ChristianAffinity/Cruz-AVEIRO/Pantilla Calidad Cruces.docx

# CONTROL DE CALIDAD CRUCES

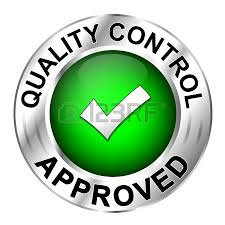
[picture p1: figure]

F-G-0602

DATOS DEL EQUIPO
Modelo: | Fecha fabricación:
Denominación: | Nº Serie:

VERIFICACIÓN COMPLEMENTOS [ ]
A N/A - Carcasa [ ] [ ] - Soporte [ ] [ ] | A N/A - Router [ ] [ ]

VERIFICACIÓN MECANICA [ ]
A N/A - Soporte Pared. [ ] [ ] - Color Carcasa. [ ] [ ] | A N/A - Caja Electrónica. [ ] [ ]

VERIFICACIÓN FUNCIONAL [ ]
A N/A - Animaciones. [ ] [ ] - Hora. [ ] [ ] - Control de Brillo. [ ] [ ] - Configuración Router [ ] [ ] | A N/A - Comunicación WI-FI [ ] [ ] - Leds. [ ] [ ] - Sonda de temperatura [ ] [ ] - Test 3 días [ ] [ ]

VERIFICACIÓN OPTICA [ ]
A N/A - Rayas y raspaduras [ ] [ ] - Color homogéneo Leds [ ] [ ] - Hora correcta [ ] [ ] - Leds RGB todos encendidos [ ] [ ] | A N/A - Etiqueta N.º de serie equipo [ ] [ ] - Etiqueta N.º de serie piezas [ ] [ ] - Color blanco de leds Homogéneo [ ] [ ]

Este equipo ha superado las pruebas y controles de calidad para su suministro

Fdo.: Responsable Calidad

| CONTROL VERIFICACIÓN MONTAJE DE CRUCES
| CODIGO:
| FECHA:
| NUMERO SERIE:

TECNOLOGIAS ADE S.L. C/ Navarra, 38 C/ Solsona, 152 Tlf.: +34 902 103 686 28961 Villanueva de la Cañada 08223 Terrassa e-mail: affinity@affinityelectronics.com Madrid Barcelona http://www.affypharmacy.com/ ESPAÑA
