ChristianAffinity/Cruz-AVEIRO/P10/P10SMD 320x320mm-module and accessories dimension.pptx

Cabinet :
1. Make 5 windows on corresponding position of Cross in front
2. The back can be a complete sheet, welding some Threaded poles to mount power supplies, Receiving Card, T3 Card
3. If it works in very hot temperature, a fan can be added for cooling
4. All parts can be assembled and dismounted from front
5. Reserve a hole for AC Mains power cable input
6. Reserve 2 holes for T3 Card Antennas
7. Keep all holes and fixing positions water resisted.

P10 Module: 320x320x22mm

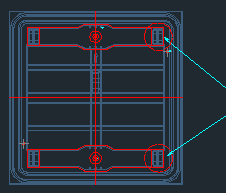
[picture p2: figure]

Cabinet Reference

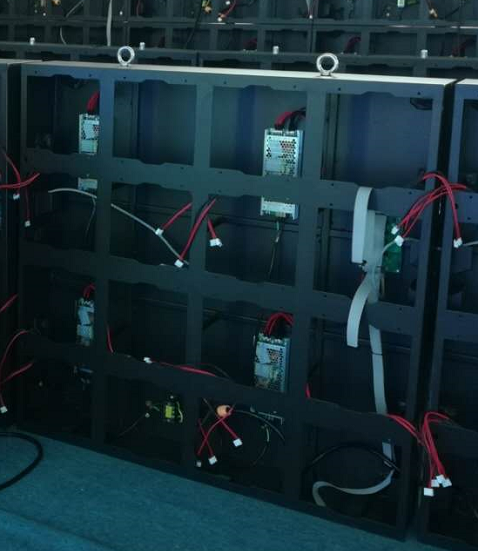
[picture p3: figure]

Locks

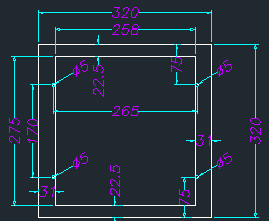
[picture p4: figure]

## Slide 2

Power Supply: VAT-UP300S-5-60L-A

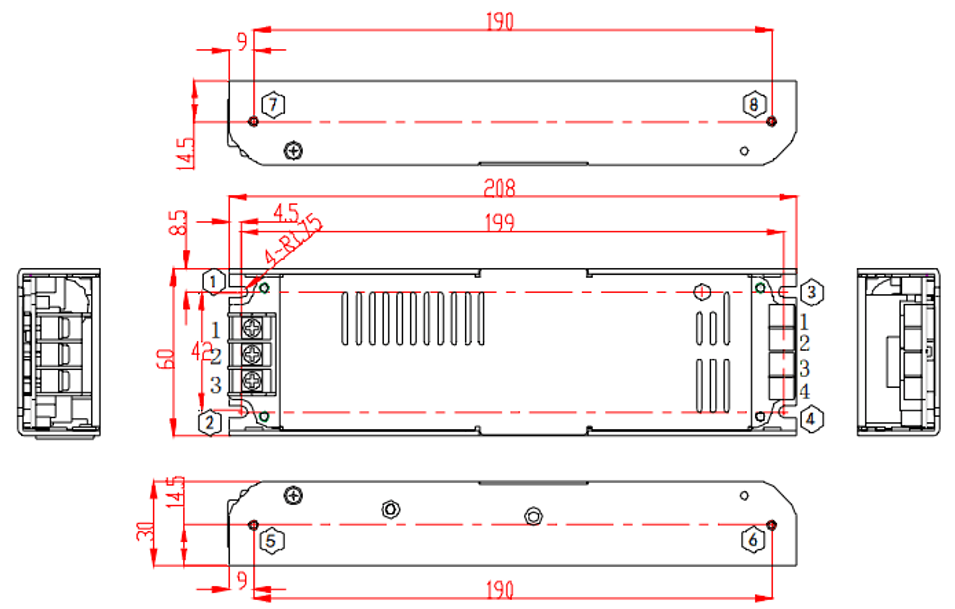
[picture p5: figure]

## Slide 3

WiFi Sending Card: T3

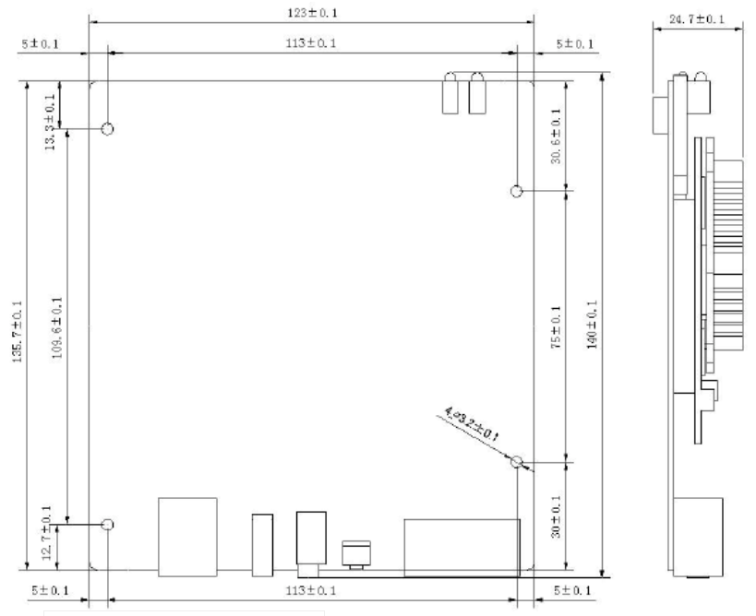
[picture p6: figure]

Receiving Card: MRV336

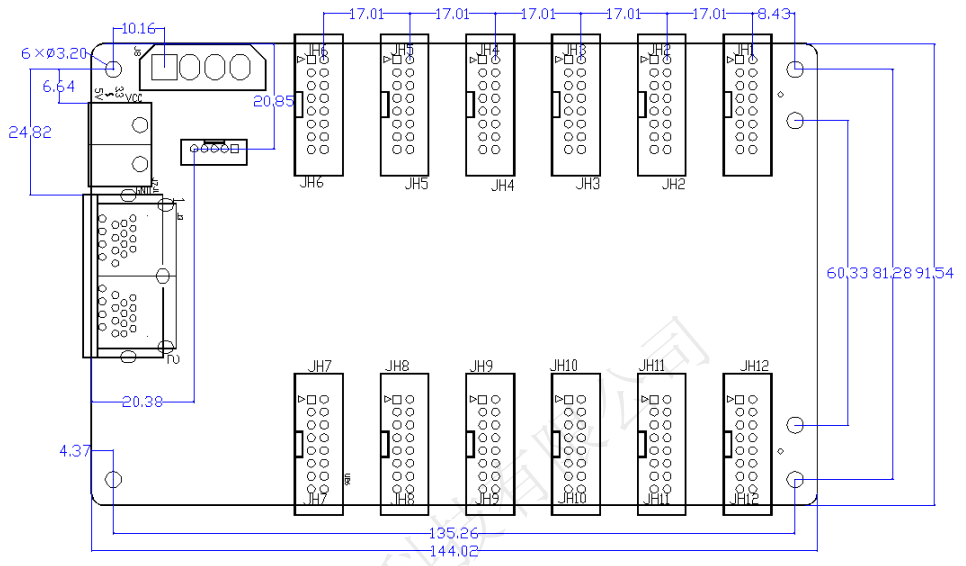
[picture p7: figure]
