ChristianAffinity/Cruz-AVEIRO/nova/media/7c5a1322309a635d3d2489f45fb7a09a.gif

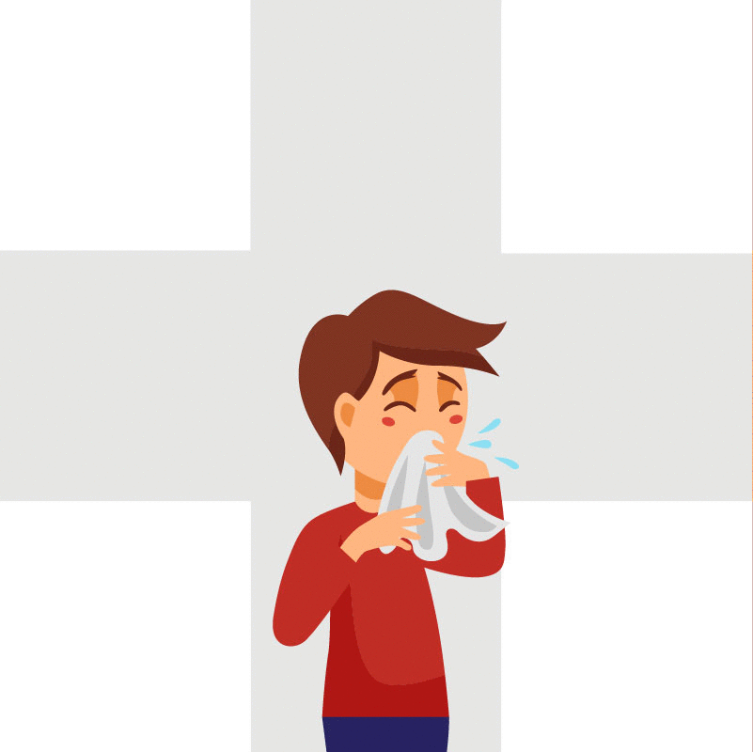
nova/media/7c5a1322309a635d3d2489f45fb7a09a.gif
