ChristianAffinity/Cruz-AVEIRO/nova/media/1917d6bfe66c499b5e2b0775bed98a57.gif

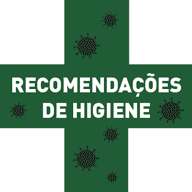
nova/media/1917d6bfe66c499b5e2b0775bed98a57.gif
