ChristianAffinity/Cruz-AVEIRO/nova/media/681648bbcf8f7aeb54e717b080c021fe.gif

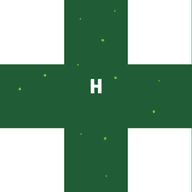
nova/media/681648bbcf8f7aeb54e717b080c021fe.gif
