ChristianAffinity/Cruz-AVEIRO/nova/media/ae6a9462dccd09d8ac21188c02434fcc.gif

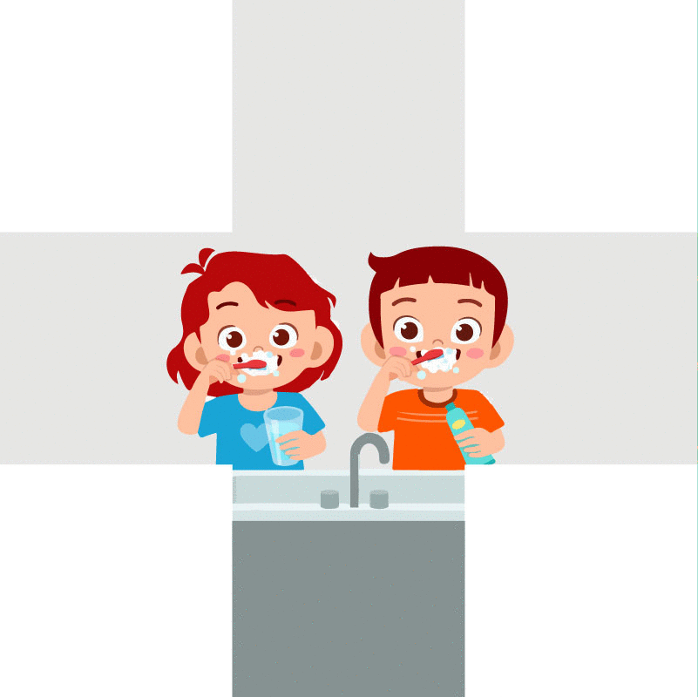
nova/media/ae6a9462dccd09d8ac21188c02434fcc.gif
