ChristianAffinity/Cruz-AVEIRO/nova/media/c2ec6c5f07720dbcca98fb366b5a2c16.gif

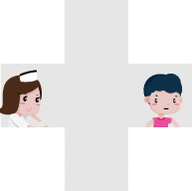
nova/media/c2ec6c5f07720dbcca98fb366b5a2c16.gif
