ChristianAffinity/Cruz-AVEIRO/nova/program/AveiroP667_288X144/e09379c5-8bc2-414f-90a1-663403e3ac25.png

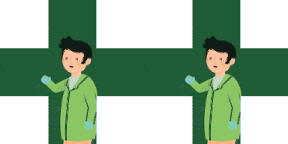
nova/program/AveiroP667_288X144/e09379c5-8bc2-414f-90a1-663403e3ac25.png
