ChristianAffinity/Cruz-AVEIRO/PlACA_2_ RECEIVING CARD p667 v2.png

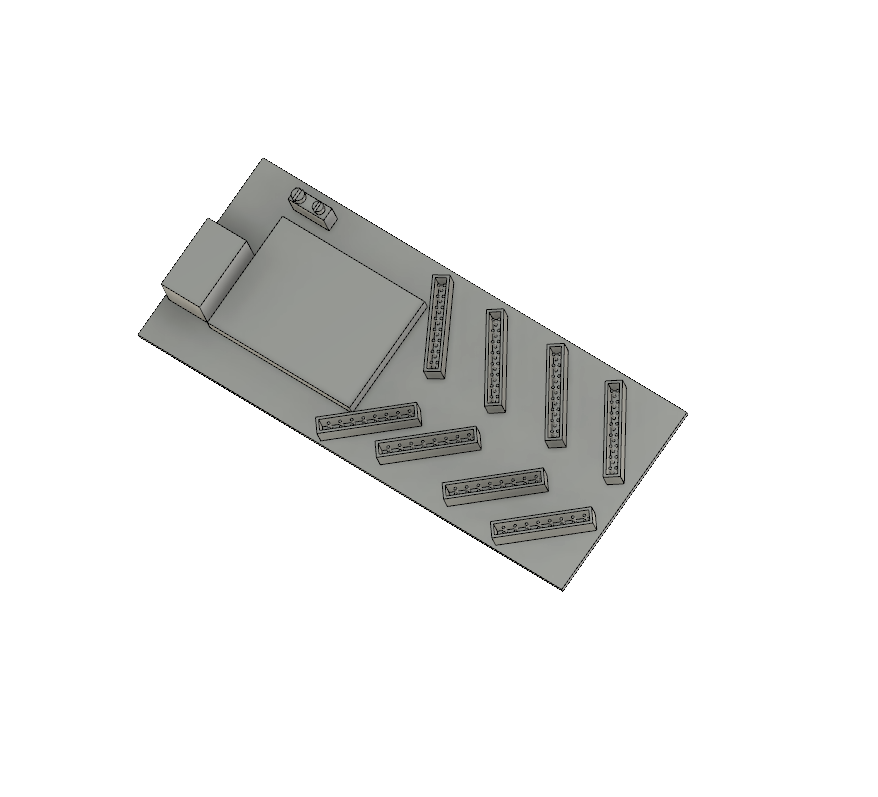
PlACA_2_ RECEIVING CARD p667 v2.png
