ChristianAffinity/Cruz-AVEIRO/Escandallo Aveiro P6.67 y P10.xlsx

Sheet: aveiro p6,67
 |  |  |  | USD | 0.83
 |  |  |  | Portes | 15%
 |  | COSTE CRUZAVEIRO P6,67 |  |  |  | 1621.47 | 5% |  | 25% | 30% | 35% | 40% | 44%
articulo | componente | R04V0001 | unidades |  | cost_ult1 |  |  | 1702.546461 | 2270.061948 | 2432.20923 | 2619.302248 | 2837.577435 | 3123.938461
R04V0001 | LMP10 | MODULOS LED P6,67 | 10 | 71 | 69.58 | 695.8000
R04V0001 | WC | WIFI CARD TB2-4G | 1 | 220 | 215.60 | 215.6000
R04V0001 | RC | RECEIVING CARD MODELO A5S PLUS | 1 | 25 | 24.50 | 24.5000
 |  | CABLE PLANO 20 VÍAS(ADESKT16H2 - 2,54) 20CM | 4
 |  | CABLE PLANO 20 VÍAS(ADESKT16H2 - 2,54) 80CM | 6
 |  | CABLE ALIMENTACIÓN ROJO / NEGRO 3MTR (MODULOS) | 10
 |  | CABLE RJ45 UTP 3MTR | 1
 |  | TORNILLO M3X15 DIN965 | 4
 |  | TUERCAS M3 | 4
 |  | SEPARADORES PVC 5MM/8MM | 4
 |  | Ensamblaje | 1 |  | 20.00 | 20.0000
 |  | CABLE ALIMENTACIÓN (R y N) RECEIVING CARD 3 MTR PUNTERAS A CONECTOR HEMBRA 4 VIAS TIPO JST PASO 3,96 ( VER PLANO) S=1,5MM | 1
 |  | TUBO CORRUGADO EUROFLEX-21 11/F 15 D 6x4 25MM | 1
 |  |  |  |  |  | 955.9000
articulo | componente | SOPORTE CRUZ AVEIRO | unidades |  | cost_ult1
 | D15V-3 | SOPORTE DE PARED 30CM | 1 |  | 32.00 | 32.0000
SE0401030000P | D04V-32 | SOPORTE CRUZ LEON - TURIN | 1 |  | 90.00 | 90.0000
SE0401030000P | TORM6X16DIN933I | TORNILLO M 6X16 DIN 933 HEXAGONAL AC. INOX. | 2 |  | 0.05 | 0.1004
SE0401030000P | TORM6X40DIN933I | TORNILLO M 6X40 DIN 933 HEXAGONAL AC. INOX. | 1 |  | 0.09 | 0.0876
SE0401030000P | ARANM4DIN9021ZN | ARANDELA M 8 DIN 9021 INOX | 3 |  | 0.01 | 0.0193
 |  |  |  |  |  | 122.2073
articulo | componente | ENVOLVENTES | unidades |  | cost_ult1
DE04VI85 | ECRGB P6 | ENVOLVENTE CRUZ RGB P10 | 1 |  | 290.00 | 290.0000
DE04VI85 | TORM4X15DIN933I | TORNILLO M4X15 DIN 933 EXAGONAL AC. INOX. | 4 |  | 0.03 | 0.128
DE04VI85 | ARANDELAP18 | ARANDELA A2 C/GOMA P18 | 4 |  | 0.07 | 0.2902
 |  |  |  |  |  | 290.4180
articulo | componente | FUENTE DE ALIMENTACIÓN | unidades |  | cost_ult1
FA2-1F | FACRGB | FUENTE ALIMENTACIÓN CRUZ RGAB P10 | 2 | 70 | 68.60 | 137.2000
FA2-1F | CV | CABLES VARIOS | 1 |  | 30.00 | 30.0000
FA2-1F | ENSAMBLAJE FA1 | ENSAMBLAJE FUENTE ALIENTACION 1 FUENTE | 1 |  | 15.00 | 15.0000
FA2-1F | AFY2500F-B-2P | BORNA 2V HEMBRA ACODADA 5.08 | 1 |  | 0.07 | 0.0695
FA2-1F | BRIDA290MM | BRIDA 290 mm X4.8 | 3 |  | 0.04 | 0.1155
FA2-1F | DIN934 M3 | TUERCA M3 DIN 934 ZN | 18 |  | 0.03 | 0.5512
FA2-1F | SEPARADOR8MMPVC | SEPARADOR 8 MM NYLON M3 | 4 |  | 0.02 | 0.0976
FA2-1F | ARANM4DIN9021ZN | ARANDELA M 8 DIN 9021 INOX | 2 |  | 0.01 | 0.0129
FA2-1F | CLEMA250 | CLEMA PARA CABLE 2.5MM (DE 10MM) | 1 |  | 0.86 | 0.8600
FA2-1F | TUBOFLEX21 | TUBO CORRUGADO EUROFLEX-21 11/F 15 D 6x4 25MM | 1 |  | 1.44 | 1.4400
 |  | CBCRUZFFRA | 1
 |  | CBCRUZFFRM | 1
FA2-1F | F10T | CONJUNTO CHAPA FUENTE 1F.A. NUEVA 9006 | 1 |  | 56.05 | 56.0472
 |  |  |  |  |  | 241.3938
 |  | ETIQUETAS
FA2-1F | ETIQUETA-GENERAL | ETIQUETA Nº SERIE AFFINITY | 4 |  | 0.07 | 0.266
R04V0001 | ETIMERCAN | ETIQUETA MERCANCIA ASEGURADA | 1 |  | 0.33 | 0.334
R04V0001 | ETIATENCION | ETIQUETA ATENCION | 1 |  | 1.00 | 1.000
R04V0001 | ETIQUETA-CRUCES | ETIQUETA Nº SERIE PARA CRUCES | 1 |  | 0.20 | 0.20
 |  |  |  |  |  | 1.800
 |  | EMBALAJE
R04V0001 | EMBPROTCRUZ | CARTON PROTECCION CRUCES | 2 |  | 0.89 | 1.780
SE0401030000P | EMBSOPCRUZ | CAJA SOPORTE CRUZ 230 X 230 X 650 | 1 |  | 0.89 | 0.885
R04V0001 | EMBC0950 | CAJA CRUCES 950 x 160 x 1350 | 1 |  | 4.57 | 4.570
 |  | PERFILES AZULES | 1 |  | 1.64 | 1.64
 |  | BURBUJA PEQ | 1 |  | 0.85 | 0.85
 |  | PAKING LIST | 1 |  | 0.03 | 0.03
 |  |  |  |  |  | 9.75

Sheet: aveiro p10
 |  |  | usd | 0.84
 |  |  | Portes | 10%
 |  | COSTE CRUZ AVEIRO P10 |  |  |  | 1480.2231 | 5% |  | 25% | 30% | 35% | 40% | 44%
articulo | componente | R04V0001 | unidades |  | cost_ult1 |  |  | 1554.234286 | 2072.312382 | 2220.334695 | 2391.129672 | 2590.390477 | 2851.80603
R04V0001 | LMP10 | MODULOS LED P10 | 10 | 56 | 52.64 | 526.4000
R04V0001 | WC | WIFI CARD TB2-4G | 1 | 220 | 206.80 | 206.8000
R04V0001 | RC | RECEIVING CARD MODELO MRV 336 | 1 | 25 | 23.50 | 23.5000
 |  | CABLE PLANO 16 VÍAS(ADESKT16H2 - 2,54) 20CM | 8
 |  | CABLE PLANO 16 VÍAS(ADESKT16H2 - 2,54) 80CM | 12
 |  | CABLE ALIMENTACIÓN ROJO / NEGRO 3MTR (MODULOS) | 10
 |  | CABLE RJ45 UTP 3MTR | 1
 |  | CABLE ALIMENTACIÓN (R y N) RECEIVING CARD 3 MTR PUNTERA A HORQUILLA | 1
 |  | TORNILLO M3X15 DIN965 | 4
 |  | TUERCAS M3 | 4
 | SEPARADOR8MMPVC | SEPARADORES PVC 5MM/8MM | 4
 |  | ENSAMBLAJE | 1 |  | 25.00 | 25.0000
 |  | TUBO CORRUGADO EUROFLEX-21 11/F 15 D 6x4 25MM | 1 |  | 1.44 | 1.4400
 |  |  |  |  |  | 783.1400
articulo | componente | SOPORTE CRUZ AVEIRO | unidades |  | cost_ult1
 | D15V-3 | SOPORTE DE PARED 30CM | 2 |  | 32.00 | 64.0000
SE0401030000P | D04V-32 | SOPORTE CRUZ AVEIRO | 1 |  | 90.00 | 90.0000
 |  | TAPON NEGRO | 2
SE0401030000P | TORM6X16DIN933I | TORNILLO M 6X16 DIN 933 HEXAGONAL AC. INOX. | 4 |  | 0.05 | 0.2009
SE0401030000P | TORM6X40DIN933I | TORNILLO M 6X40 DIN 933 HEXAGONAL AC. INOX. | 4 |  | 0.09 | 0.3502
SE0401030000P | ARANM4DIN9021ZN | ARANDELA M 8 DIN 9021 INOX | 6 |  | 0.01 | 0.0386
 |  |  |  |  |  | 154.5898
articulo | componente | ENVOLVENTES | unidades |  | cost_ult1
DE04VI85 | ECRGB P6 | ENVOLVENTE CRUZ RGB P10 | 1 |  | 290.00 | 290.0000
 |  |  |  |  |  | 290.0000
articulo | componente | FUENTE DE ALIMENTACIÓN | unidades |  | cost_ult1
FA2-1F | RSP-500-5 | FUENTE ALIMENTACIÓN CRUZ RGAB P10 | 2 | 72 | 67.68 | 135.3600
FA2-1F |  | PLACA CPU WIFI | 1 |  | 30.00 | 30.0000
 |  | ROUTER WIFI | 1
 |  | TORNILLO C/PLANA M4*10 | 8
 | CAB000330 | CABLE RED | 1
FA2-1F | ENSAMBLAJE FA1 | ENSAMBLAJE FUENTE ALIENTACION 1 FUENTE | 1 |  | 15.00 | 15.0000
FA2-1F | BRIDA290MM | BRIDA 290 mm X4.8 | 3 |  | 0.04 | 0.1155
FA2-1F | CLEMA250 | CLEMA PARA CABLE 2.5MM (DE 10MM) | 2 |  | 0.86 | 1.7200
 |  | CBCRUZFFRA | 1
 |  | CBCRUZFFRM | 1
FA2-1F | F40T | CONJUNTO CHAPA FUENTE 1F.A. NUEVA 9006 | 1 |  | 56.05 | 56.0472
 |  |  |  |  |  | 238.2427
 |  | ETIQUETAS
FA2-1F | ETIQUETA-GENERAL | ETIQUETA Nº SERIE AFFINITY | 2 |  | 0.07 | 0.133
R04V0001 | ETIMERCAN | ETIQUETA MERCANCIA ASEGURADA | 1 |  | 0.33 | 0.334
R04V0001 | ETIATENCION | ETIQUETA ATENCION | 1 |  | 1.00 | 1.000
R04V0001 | ETIQUETA-CRUCES | ETIQUETA Nº SERIE PARA CRUCES | 1 |  | 0.20 | 0.20
 |  |  |  |  |  | 1.667
 |  | EMBALAJE
R04V0001 | EMBPROTCRUZ | CARTON PROTECCION CRUCES | 2 |  | 0.89 | 1.780
SE0401030000P | EMBSOPCRUZ | CAJA SOPORTE CRUZ 230 X 230 X 650 | 1 |  | 0.89 | 0.885
R04V0001 | EMBC1250 | CAJA CRUCES 1250 x 160 x 1500 | 1 |  | 7.40 | 7.400
 |  | PERFILES AZULES | 1 |  | 1.64 | 1.64
 |  | BURBUJA PEQ | 1 |  | 0.85 | 0.85
 |  | PAKING LIST | 1 |  | 0.03 | 0.03
 |  |  |  |  |  | 12.58
 |  |  |  |  |  | 1480.22
