ChristianAffinity/Cruz-AVEIRO/CAD/CAD Fuente alimentación/Ensamblaje1.SLDASM

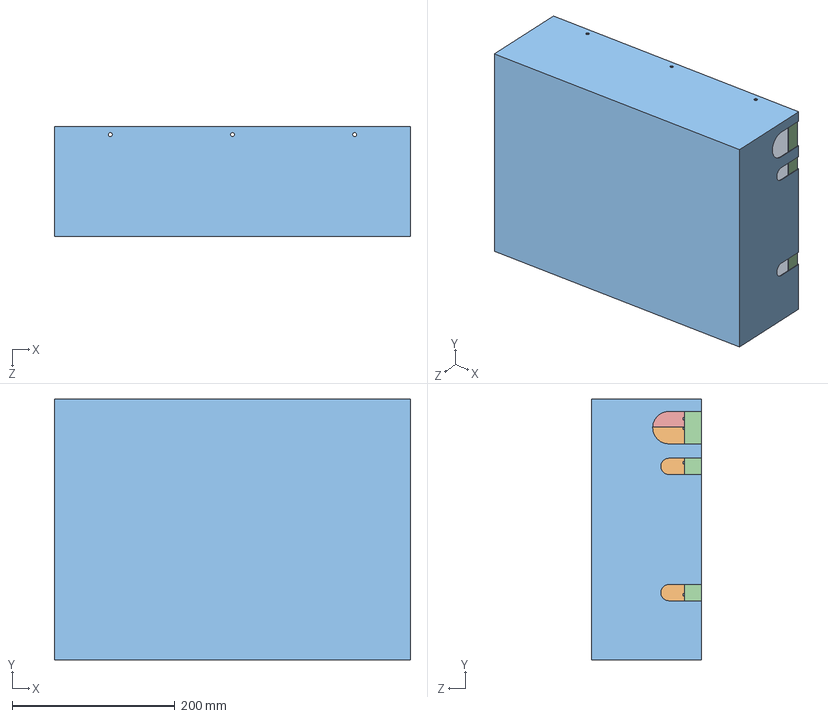
[picture p15: CAD file, 2021-09-20]
CAD/CAD Fuente alimentación/Ensamblaje1.SLDASM
437.0 x 320.0 x 135.0 mm
CHAPA
fuente RSP-500-5 x 2
tapa fuente aveiro
Base tapa fuente aveiro
proteccion fuente aveiro
