ChristianAffinity/Cruz-AVEIRO/CAD/CAD Fuente alimentación/3D/proteccion fuente aveiro.SLDPRT

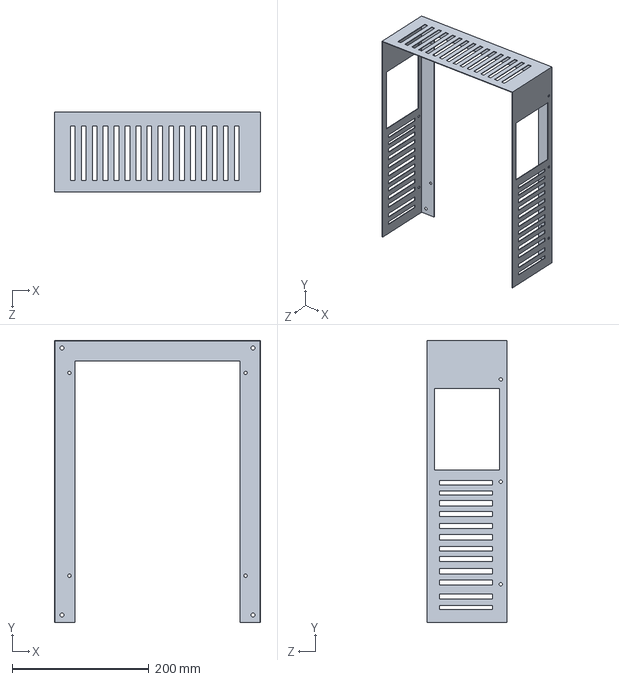
[picture p16: CAD file, 2021-09-20]
CAD/CAD Fuente alimentación/3D/proteccion fuente aveiro.SLDPRT
302.0 x 413.0 x 117.0 mm
