ChristianAffinity/Cruz-AVEIRO/CARA 1 Interior AVEIRO v20.step

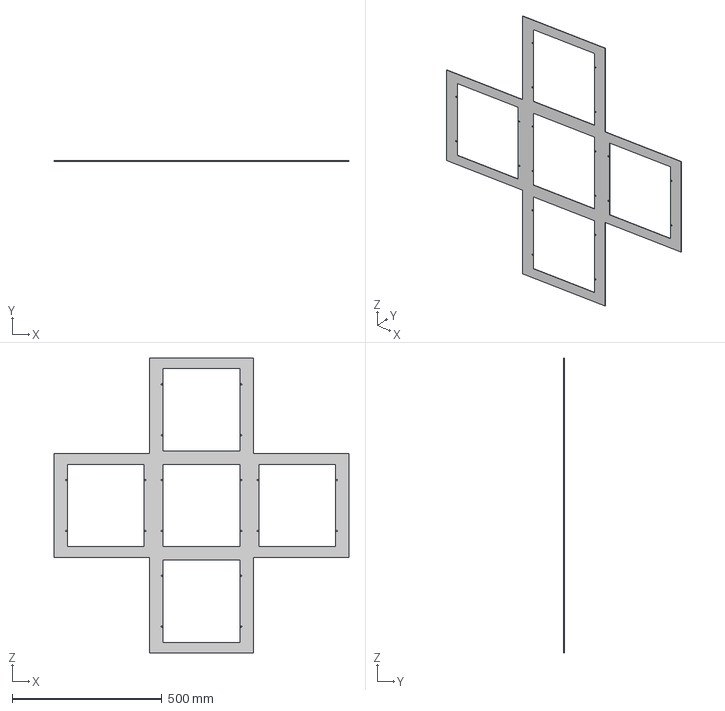
[picture p17: CAD file, 2022-04-19]
CARA 1 Interior AVEIRO v20.step
986.0 x 1.50 x 986.0 mm
