ChristianAffinity/Cruz-AVEIRO/CAD/CAD Fuente alimentación/3D/tapa fuente aveiro.SLDPRT

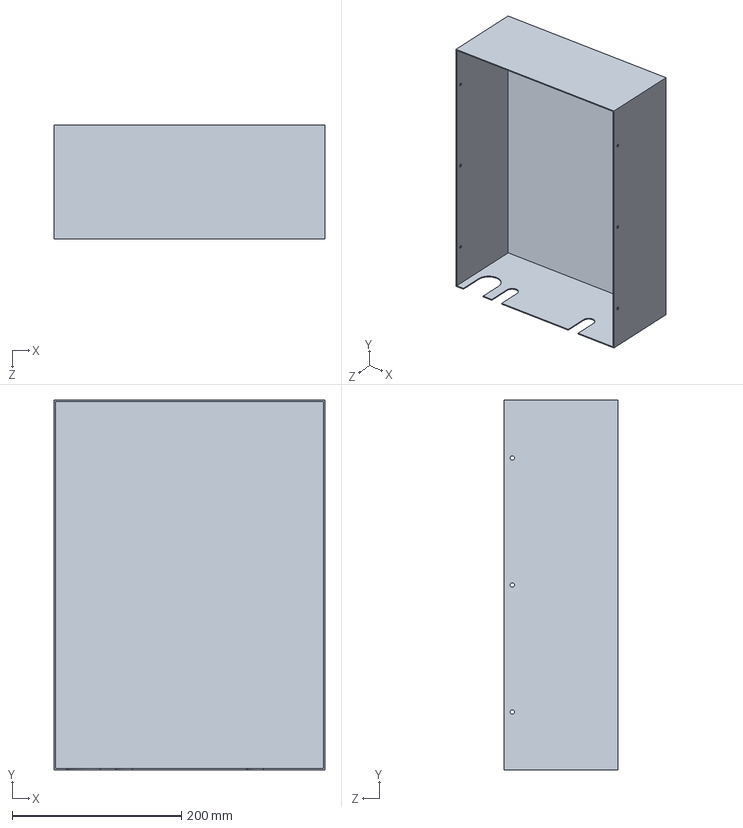
[picture p18: CAD file, 2021-09-20]
CAD/CAD Fuente alimentación/3D/tapa fuente aveiro.SLDPRT
320.0 x 437.0 x 135.0 mm
