ChristianAffinity/Cruz-AVEIRO/CAD/CAD Fuente alimentación/3D/Base tapa fuente aveiro.SLDPRT

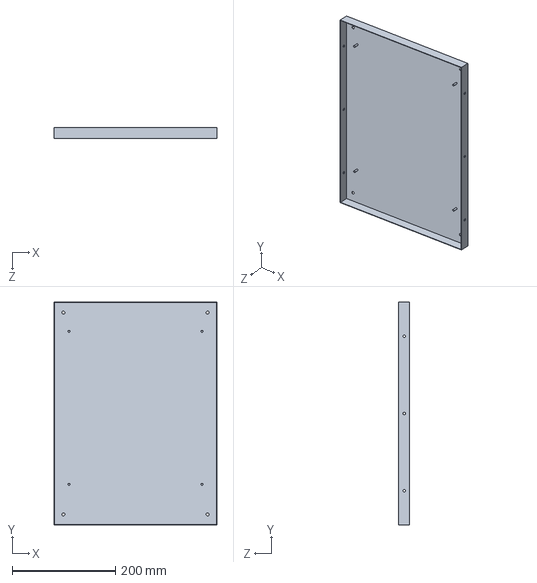
[picture p19: CAD file, 2021-09-20]
CAD/CAD Fuente alimentación/3D/Base tapa fuente aveiro.SLDPRT
316.0 x 433.0 x 21.0 mm
