ChristianAffinity/Cruz-AVEIRO/CAD/CAD Fuente alimentación/3D/fuente RSP-500-5.SLDPRT

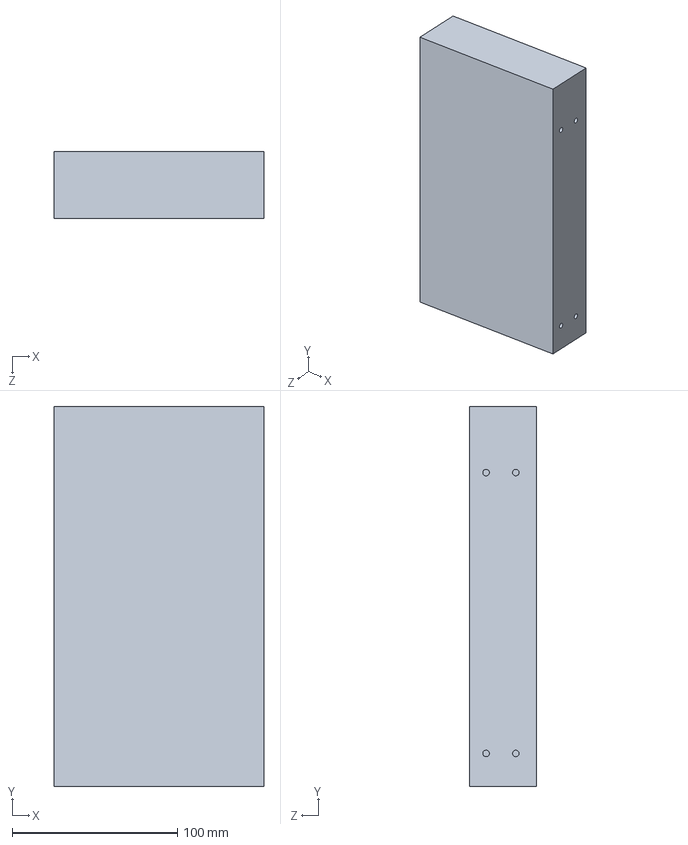
[picture p20: CAD file, 2021-09-20]
CAD/CAD Fuente alimentación/3D/fuente RSP-500-5.SLDPRT
127.0 x 230.0 x 40.5 mm
