ChristianAffinity/Cruz-AVEIRO/CAD/CAD Fuente alimentación/3D/CHAPA.SLDPRT

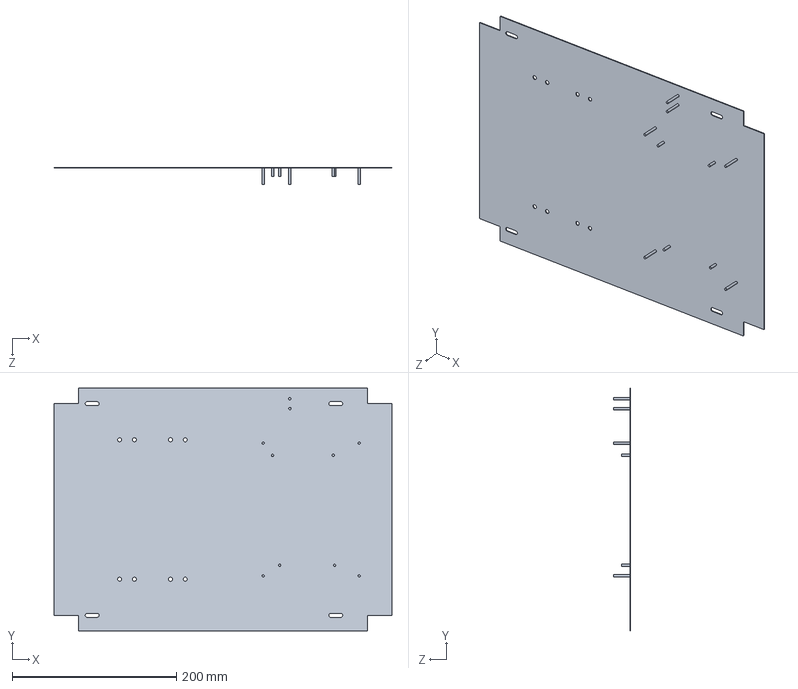
[picture p21: CAD file, 2021-09-20]
CAD/CAD Fuente alimentación/3D/CHAPA.SLDPRT
412.0 x 296.0 x 21.0 mm
