ChristianAffinity/Cruz-AVEIRO/(list of files, cad)

Other CAD files:
CAD/CAD Fuente alimentación/2D/Base tapa fuente aveiro.SLDDRW
CAD/CAD Fuente alimentación/2D/CHAPA.SLDDRW
CAD/CAD Fuente alimentación/2D/Plano cable 3m alimentacion paneles AVEIRO.SLDDRW
CAD/CAD Fuente alimentación/2D/proteccion fuente aveiro.SLDDRW
CAD/CAD Fuente alimentación/2D/tapa fuente aveiro.SLDDRW
