ChristianAffinity/Cruz-AVEIRO/P10/Double Side/P10 double-sided Cross Display Setup.docx

P10 Double-Sided Outdoor Cross Display Setup

General Information:

There are 4 sets of double-sided of P10 Cross LED displays in this order. Each set includes 10 modules of both faces, 1 TB2 WiFi card, 1 Receiving Card, 4 power supplies.

1. Module Layout

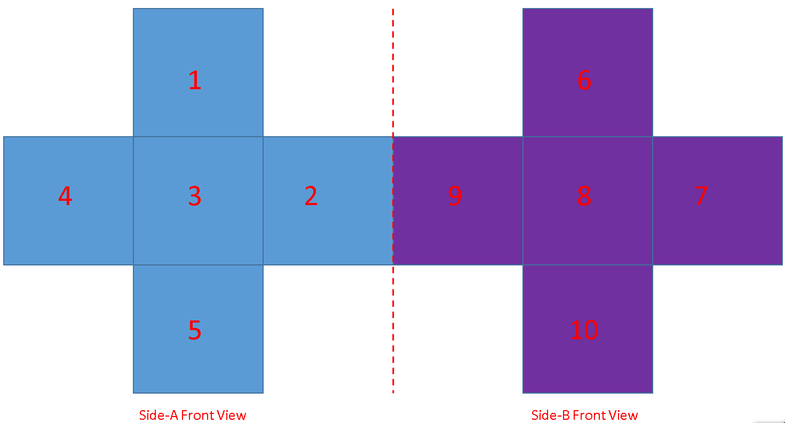
[picture p53: figure]

2. Cable Connection
1) DC 5V Power Cable

1 PSU can supply 3 Modules.

2) Flat Cables.

2 Kinds of Flat cables are included. The longer cable is from Receiving Card to Modules. The shorter one is from module to module.

According to above module layout of each side, run the flat cables from receiving card to modules, and from modules to modules accordingly. Please follow below table to connect the cables on corresponding connectors:

Longer Flat Cable Connections (Receiving Card - Module)
| Receiving Card | Module-Connector
Side A | JP1 | 1-IN1
| JP2 | 1-IN2
| JP3 | 2-IN1
| JP4 | 2-IN2
| JP5 | 5-IN1
| JP6 | 5-IN2
Side B | JP7 | 6-IN1
| JP8 | 6-IN2
| JP9 | 7-IN1
| JP10 | 7-IN2
| JP11 | 10-IN1
| JP12 | 10-IN2

Shorter Flat Cable Connections (Module - Module)
| Module-Connector | | Module-Connector
Side A | 2-OUT1 | 3-IN1 | 3-OUT1 | 4-IN1
| 2-OUT2 | 3-IN2 | 3-OUT2 | 4-IN2
Side B | 7-OUT1 | 8-IN1 | 8-OUT1 | 9-IN1
| 7-OUT2 | 8-IN2 | 8-OUT2 | 9-IN2

3) Net Cable

Connect Net Cable from WiFi Card “LED Out” to Receiving Card

3. Operation

The 2 sides of the display can be considered as a whole screen, 192x96 pixels. If the same content is expected to display on both sides, the screen can be divided into 2 windows when making programs.
