ChristianAffinity/Cruz-AVEIRO/Manual de Instalação da Cruz Aveiro_V1.2_PT (002).pdf

MANUAL DE INSTALAÇÃO CRUZ AVEIRO

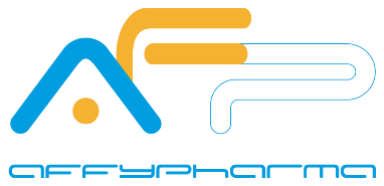
[picture p54: figure]
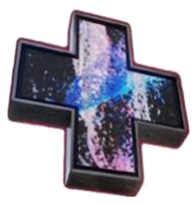
[picture p55: figure]

AFFINITY Group e-mail: affinity@affinityelectronics Tlf.: +34 918 155 723

# Manual de Instalação da Cruz Aveiro

HISTORICO DE APROVACION Y EDICIÓN

EDICIÓN Nº | FECHA | PUNTOS | CAUSE DE LOS CAMBIOS
01 | 16/12/21 | All | Creación del documento
02 | 29/03/2022 | 7 | Se añade la CPU T30

## 1. VERSÕES CRUZ AVEIRO

A cruz Aveiro é fabricada em duas versões:

Código | Descritivo | Pitch
CR4110211 | Cruz AVEIRO RGB P10 | P10
CR4010211 | Cruz AVEIRO RGB P6.67 | P6.67

## 2. PROCESSO DE INSTALAÇÃO CRUZ AVEIRO

A montagem dos módulos de led na estrutura metálica deve seguir os passos seguintes:

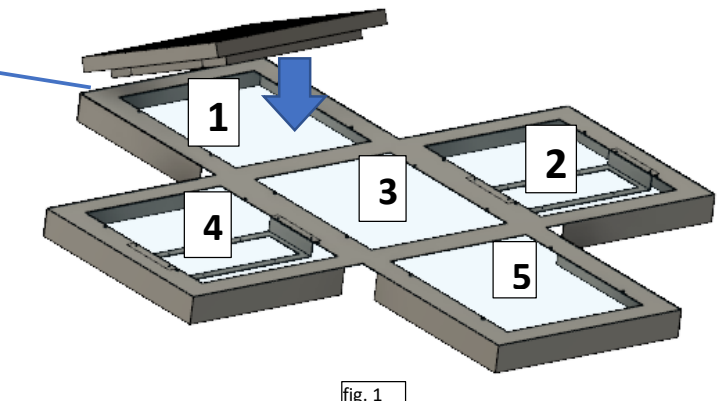
[picture p56: figure]

O módulo deve estar orientado de tal forma que a seta (fig.2) traseira aponte para a pega da cruz, conforme fig.1.

A montagem/desmontagem do módulo de led é feita com uma chave hexagonal (Allen) de 1.5mm (fig.3) através dos dois orificios situados no módulo (fig. 4).

PEGA

fig. 1

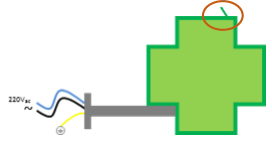
[picture p57: figure]
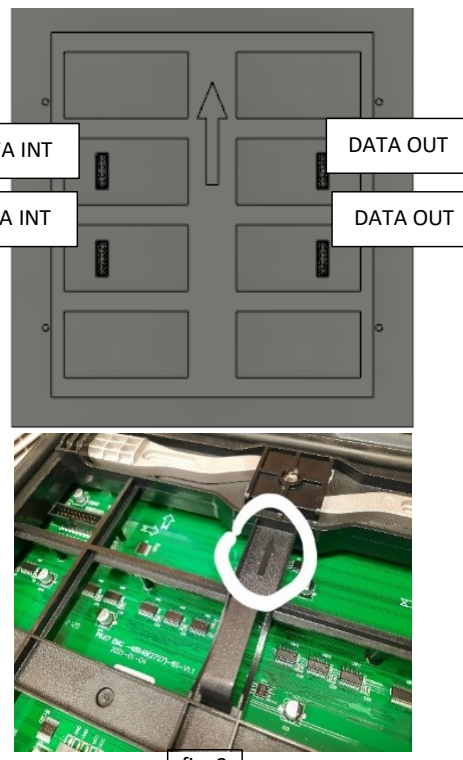
[picture p58: figure]
DATA OUT

DATA INT

DATA INT

fig. 2

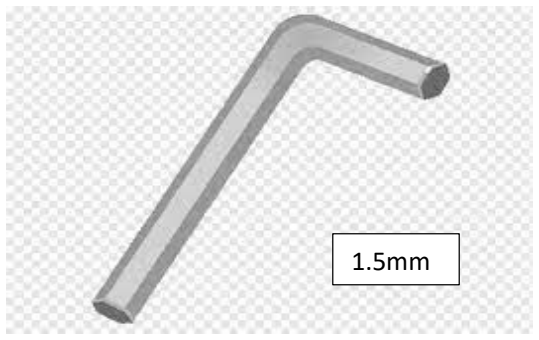
[picture p59: figure]

fig. 3

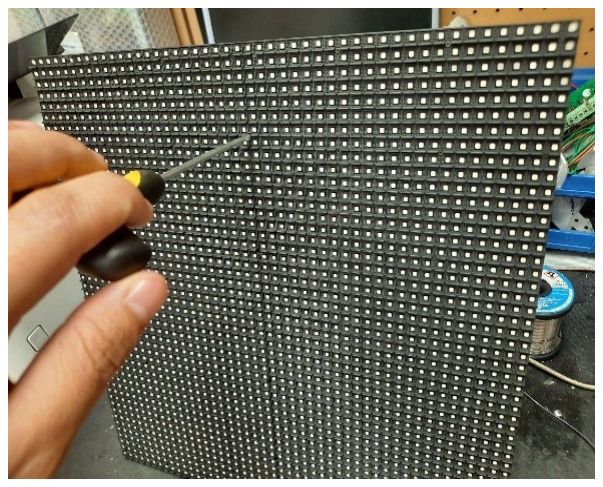
[picture p60: figure]
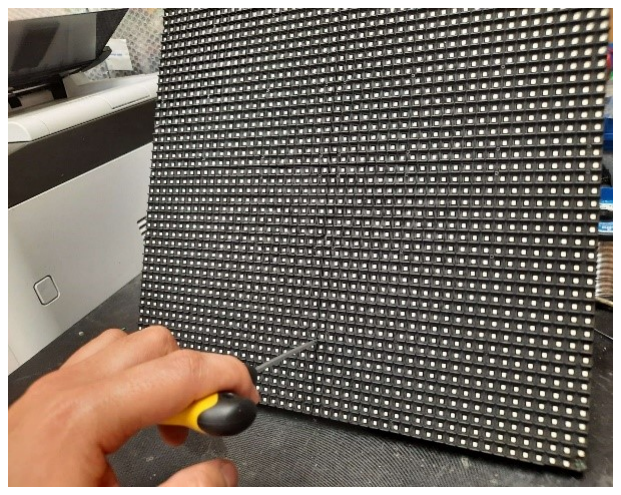
[picture p61: figure]

fig. 4

## 3. Cruz Aveiro RGB P10 (cod. CR4010211)

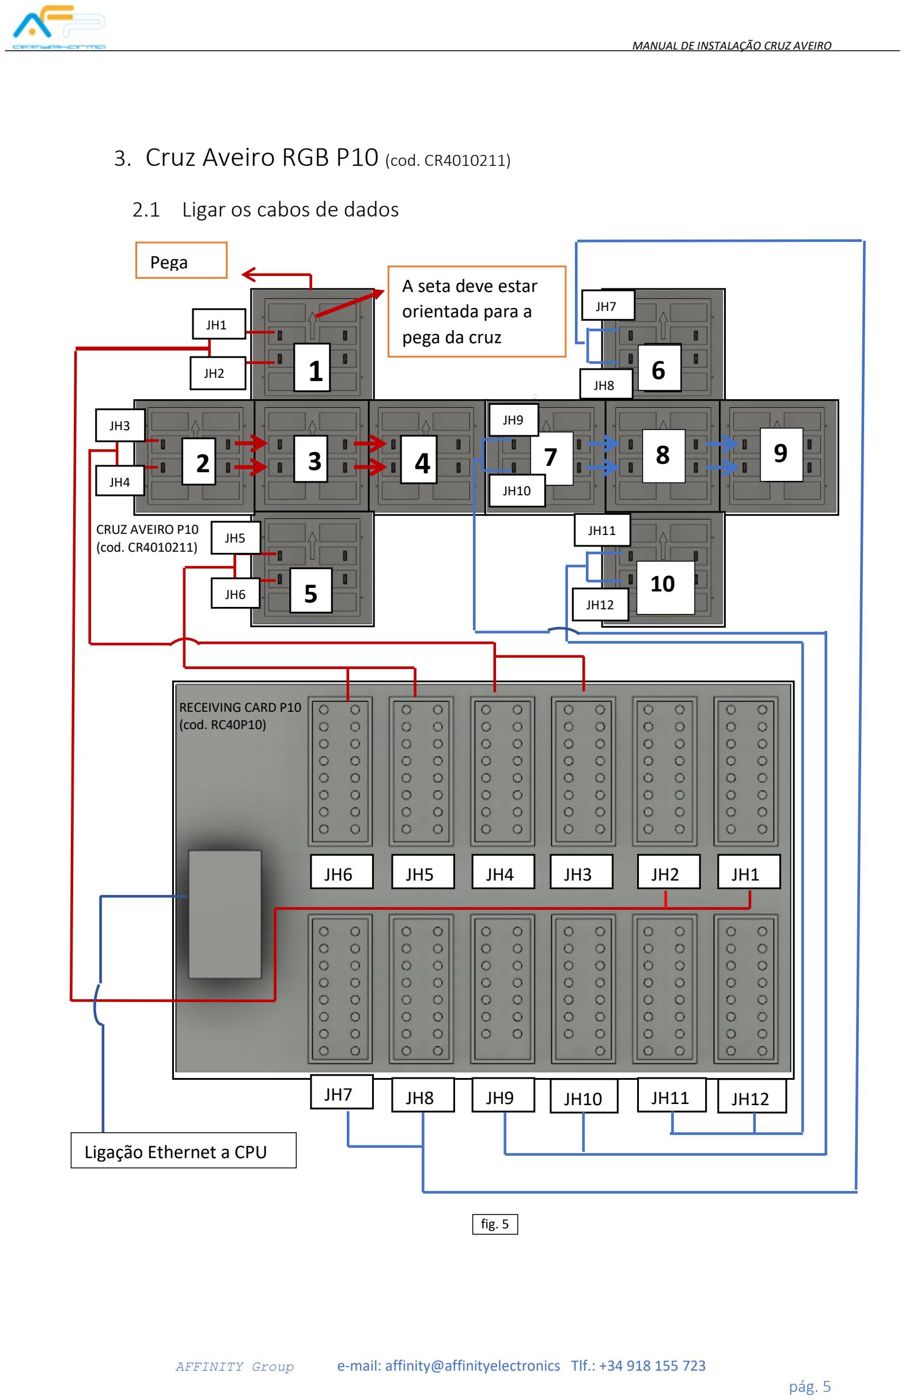
[picture p62: page 5]

### 2.1 Ligar os cabos de dados

JH6 | JH5 | JH4 | JH3 | JH2 | JH1
JH7 | JH8 | JH9 | JH10 | JH11 | JH12

1

2 | 3 | 4

5

1

4 | 3 | 2

5

6

7 | 8 | 9

10

Ligação Ethernet a CPU

A seta deve estar
orientada para a
pega da cruz

Pega

CRUZ AVEIRO P10
(cod. CR4010211)

RECEIVING CARD P10
(cod. RC40P10)

fig. 5

JH2

JH1

JH3

JH4

JH5

JH6

JH9

JH10

JH11

JH12

JH7

JH8

### 2.2 Ligar a Alimentação

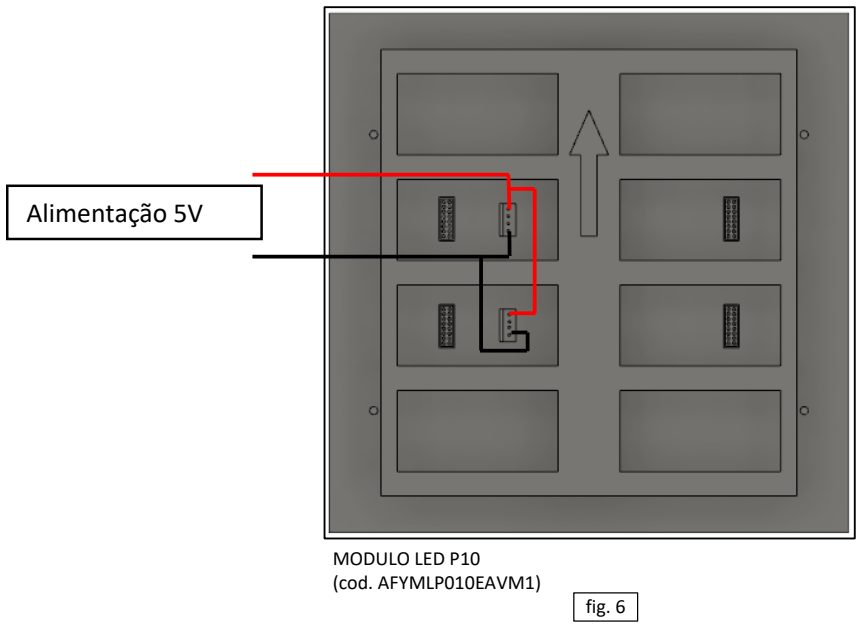
[picture p63: figure]
Alimentação 5V; MODULO LED P10 (cod. AFYMLP010EAVM1); fig. 6

Alimentação 5V

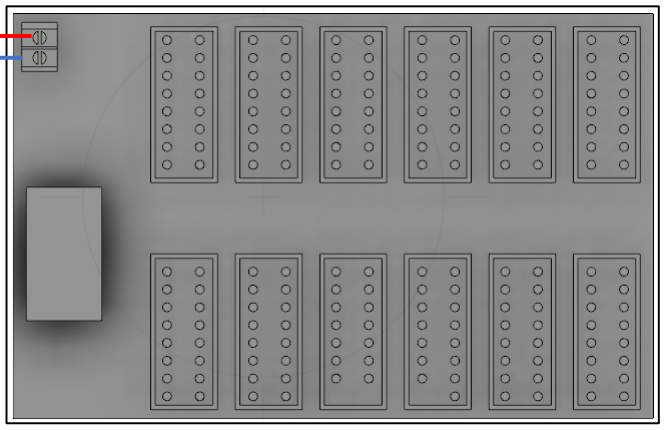
[picture p64: figure]

RECEIVING CARD P10
(cod. RC40P10)
fig. 7

## 4. AVEIRO P6.67

1

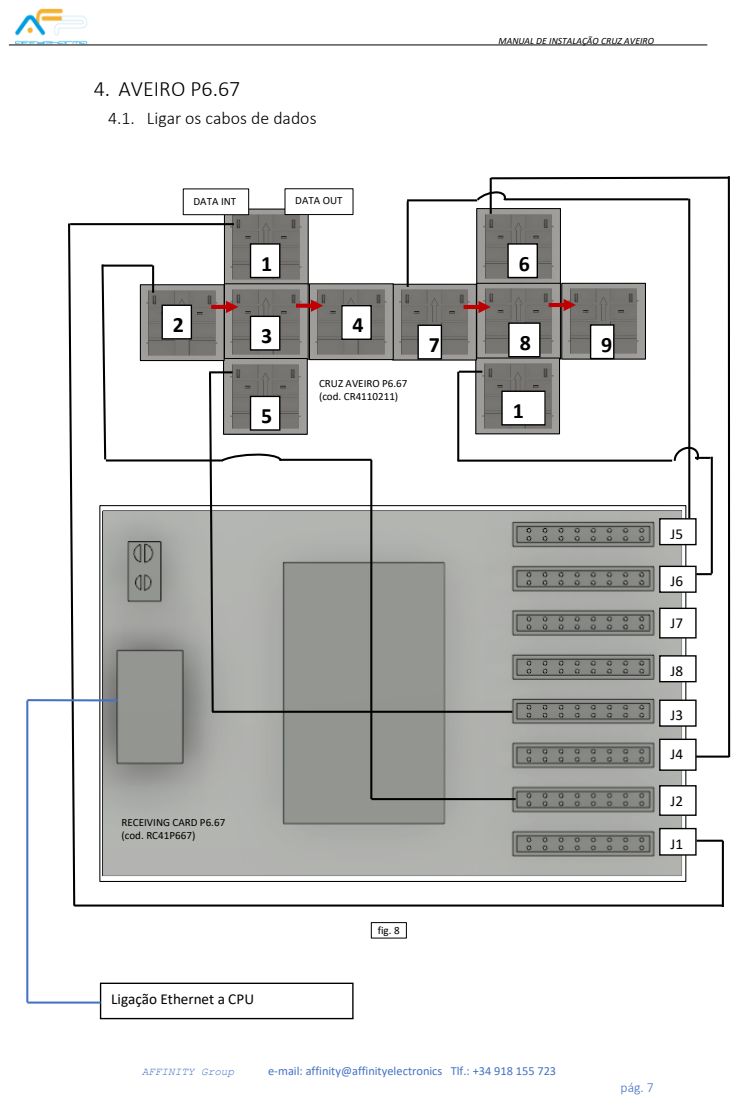
[picture p65: page 7]

4.1. Ligar os cabos de dados

### 4.2. Ligar os cabos de alimentação

Alimentacão 5V

Alimentação 5V

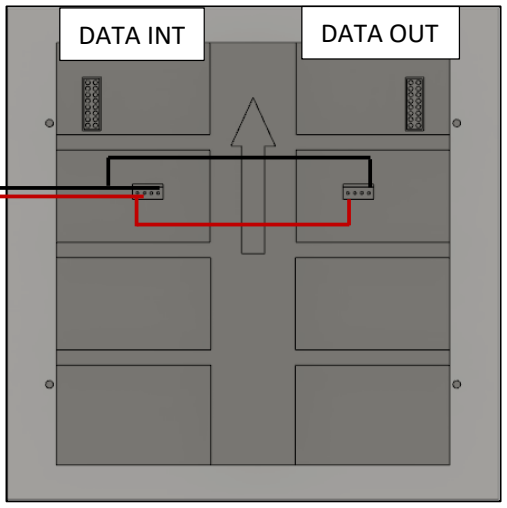
[picture p66: figure]
DATA INT; DATA OUT

MODULO LED P6.67
(cod. AFYMLP667EAVM1)

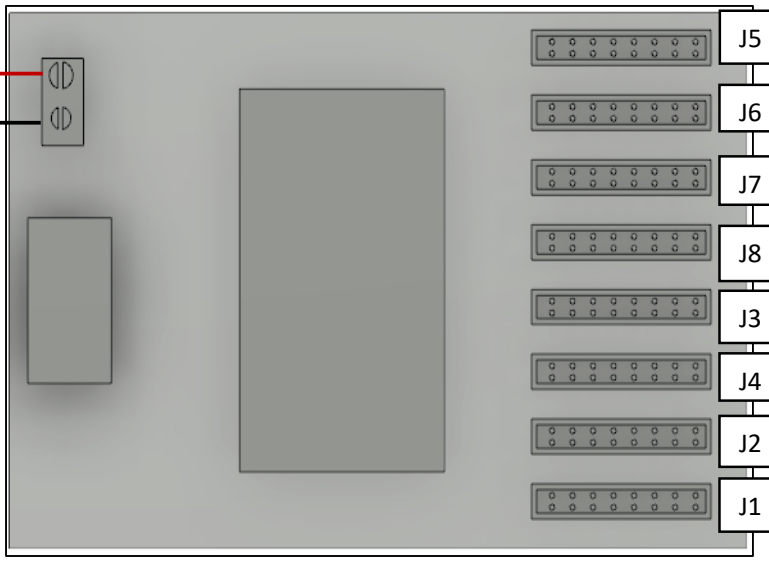
[picture p67: figure]

RECEIVING CARD P6.67
(cod. RC41P667)

fig. 9

fig. 10

## 5. MODULO DE ALIMENTAÇÃO (cod. FA-41GS)

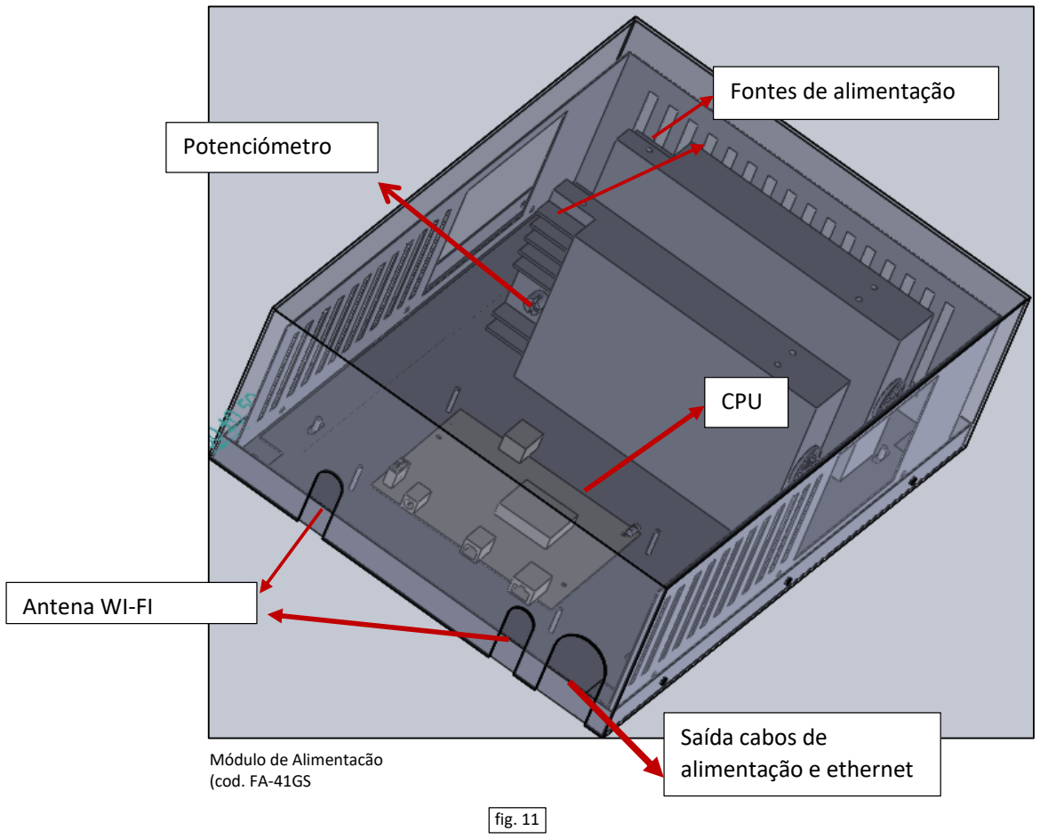
[picture p68: figure]
Potenciómetro; CPU; Fontes de alimentação; Módulo de Alimentacão (cod. FA-41GS; Antena WI-FI; Saída cabos de alimentação e ethernet; fig. 11

O módulo de alimentação FA-41GS é comúm para ambas as versões da Cruz Aveiro P10 (cod. CR4010211) e P6.67 (cod. CR4110211), inclui: CPU (cod. WCAVEIRO), duas fontes de alimentação (cod. PSP-500-5) e router (cod. WIFICRUZ-V4)

Para efeitos de dissipação as fontes de alimentação devem estar montadas conforme a fig. 11. As fontes de alimentação dispõem de um potenciómetro, cada uma, que regula a tensão de saída no intervalo de 4,45V-5,67V. Este potenciómetro deve estar ajustado por forma a que a tensão de saída seja a máxima (um ajuste abaixo afectará a intensidade da cor branca que requer mais potência).

A CPU (cod. WCAVEIRO), é comúm em ambos os modelos Aveiro, P10 e P6,67, mas a configuração do software é diferente
As portas de ligação da CPU são as seguintes:

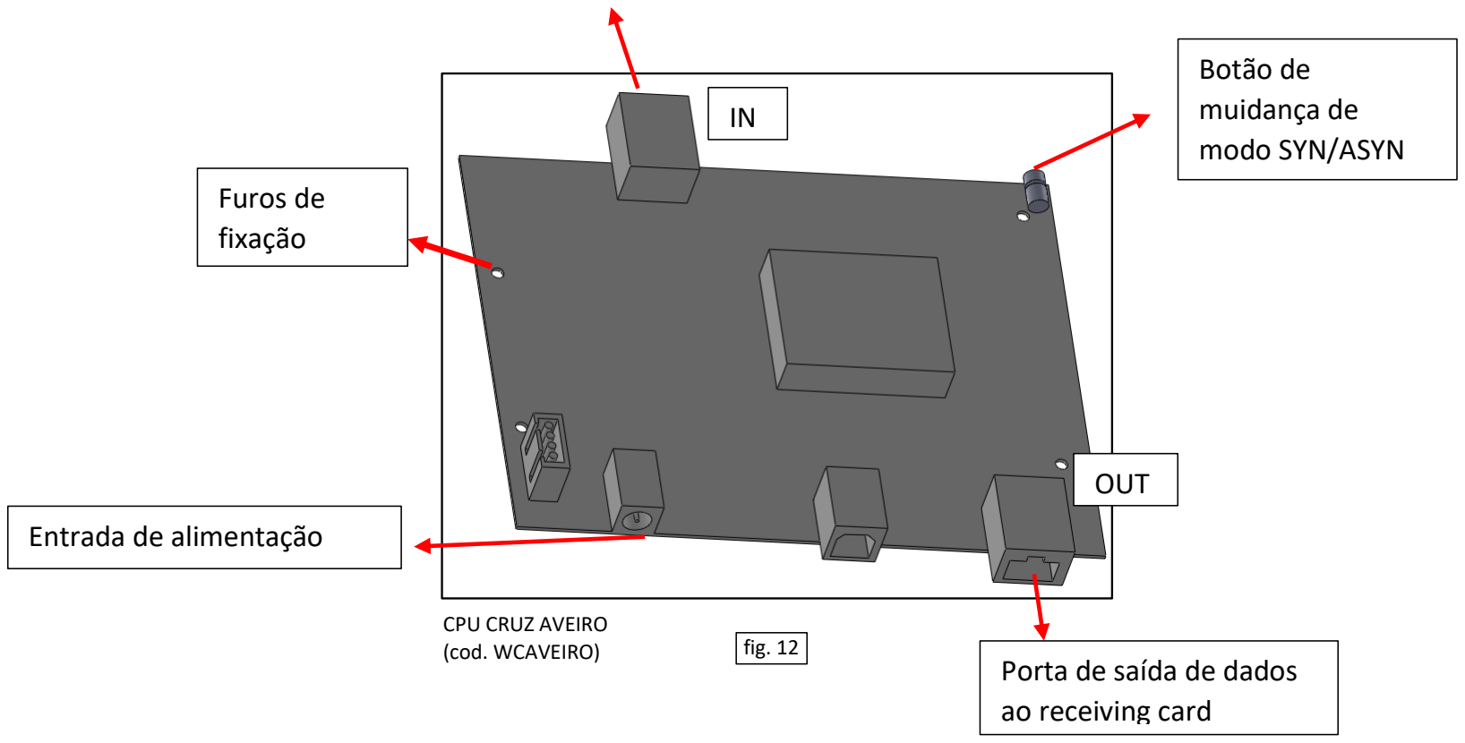
[picture p69: figure]
CPU CRUZ AVEIRO (cod. WCAVEIRO); Porta de saída de dados ao receiving card; OUT; Entrada de alimentação; Botão de muidança de modo SYN/ASYN; Furos de fixação; fig. 12

## 6. SISTEMA LIGAÇÃO ETHERNET

O sistema é composto por 3 elementos: router, CPU e receiving card correspondente.

Ligação Ethernet ao
Router

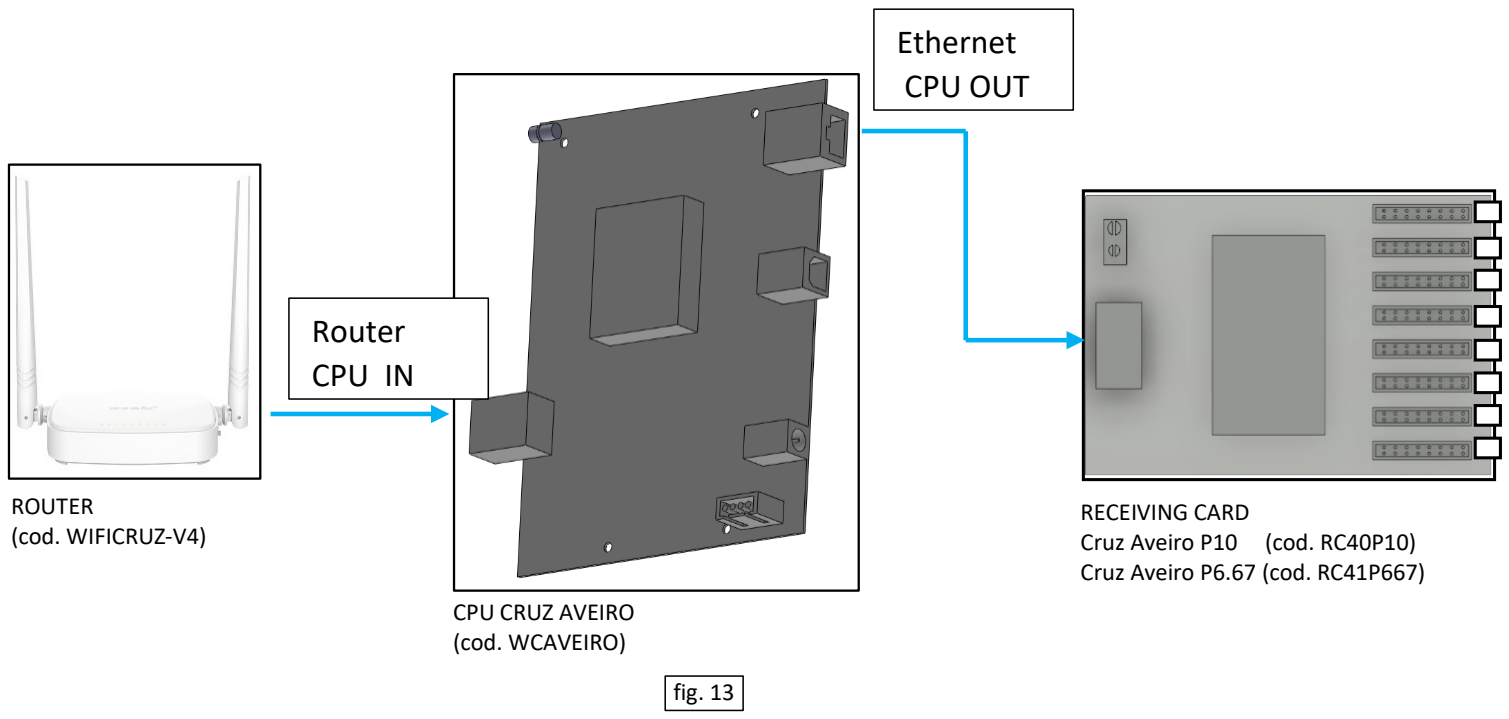
[picture p70: figure]
ROUTER (cod. WIFICRUZ-V4); Router CPU IN; Ethernet CPU OUT; CPU CRUZ AVEIRO (cod. WCAVEIRO); RECEIVING CARD Cruz Aveiro P10 (cod. RC40P10) Cruz Aveiro P6.67 (cod. RC41P667); fig. 13

## 7. LIGAÇÃO INTERNA MÓDULO DE ALIMENTAÇÃO

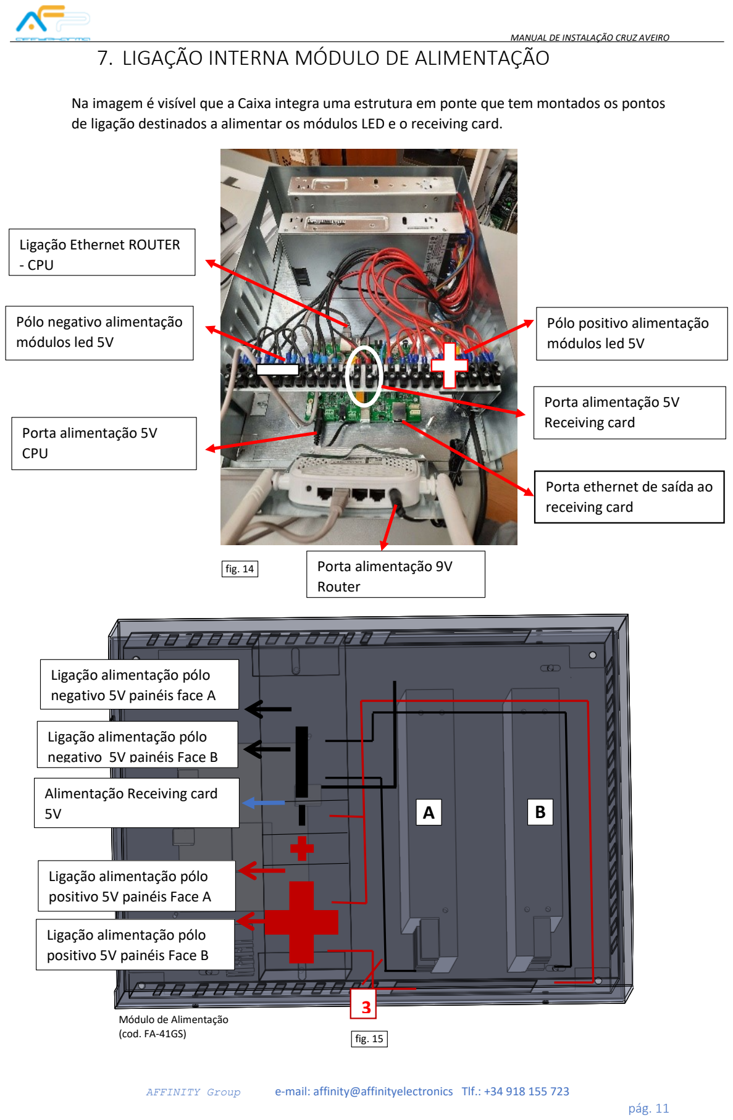
[picture p71: page 11]

Na imagem é visível que a Caixa integra uma estrutura em ponte que tem montados os pontos de ligação destinados a alimentar os módulos LED e o receiving card.

Pólo positivo alimentação
módulos led 5V

Pólo negativo alimentação
módulos led 5V

Porta alimentação 5V
Receiving card

Porta ethernet de saída ao receiving card

Porta alimentação 5V
CPU

Ligação Ethernet ROUTER
- CPU

Porta alimentação 9V
Router

B

3

Ligação alimentação pólo
negativo 5V painéis face A

Ligação alimentação pólo
negativo 5V painéis Face B

Ligação alimentação pólo
positivo 5V painéis Face A

Ligação alimentação pólo
positivo 5V painéis Face B

Alimentação Receiving card 5V

fig. 14

fig. 15

Módulo de Alimentação
(cod. FA-41GS)

A

Na figura 15, a carga é repartida pelas duas fontes de forma equilibrada pelo que devem ser ligados 5 painéis a cada fonte.

Se a carga nas fontes não está equilibrada, as cruzes ficam em tom rosa (nas zonas brancas.

Na fig. 16 estão numerados os pontos de ligação da alimentação. Assim ambas as fontes fornecem a mesma energía equilibrando o sistema.

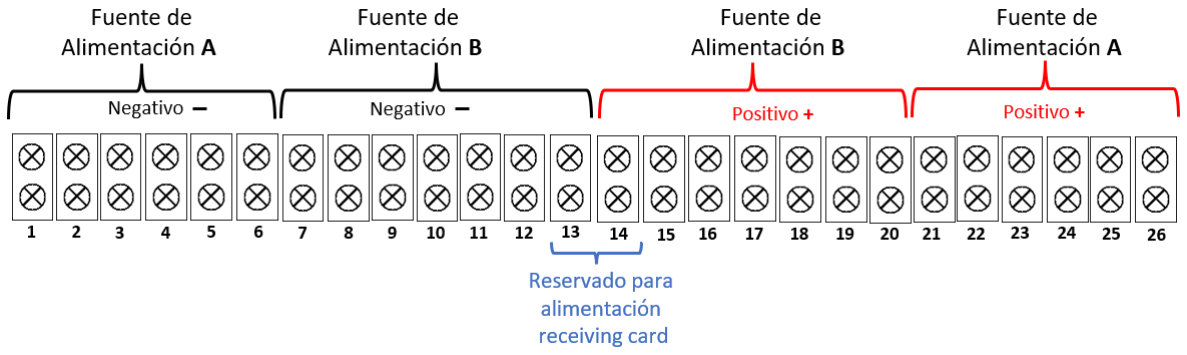
[picture p72: figure]

É importante ter em conta que a ligação da alimentação da CPU e do receiving card devem ter os polos na mesma fonte. Em caso de erro de ligação (dispositivo ligado a duas fontes distintas) o funcionamento é imprevisível.

fig. 16

## 8. ACTUALIZAÇÃO DA CAIXA DE ALIMENTAÇÃO

### 8.1. CPU T30

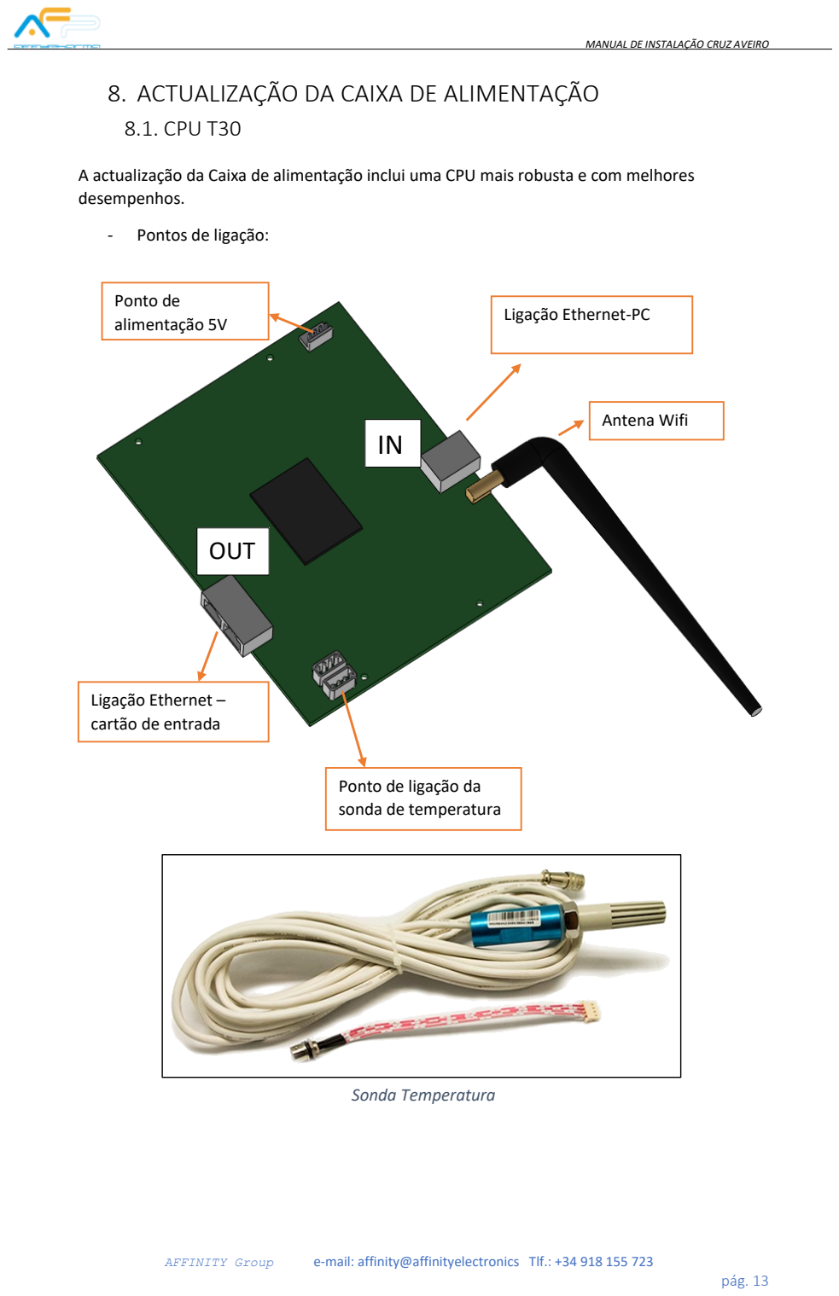
[picture p73: page 13]

A actualização da Caixa de alimentação inclui uma CPU mais robusta e com melhores desempenhos.

- Pontos de ligação:

Ponto de
alimentação 5V

Ligação Ethernet –
cartão de entrada

Ponto de ligação da
sonda de temperatura

Antena Wifi

Ligação Ethernet-PC

IN

## OUT

Sonda Temperatura

- Posição da CPU dentro da caixa:

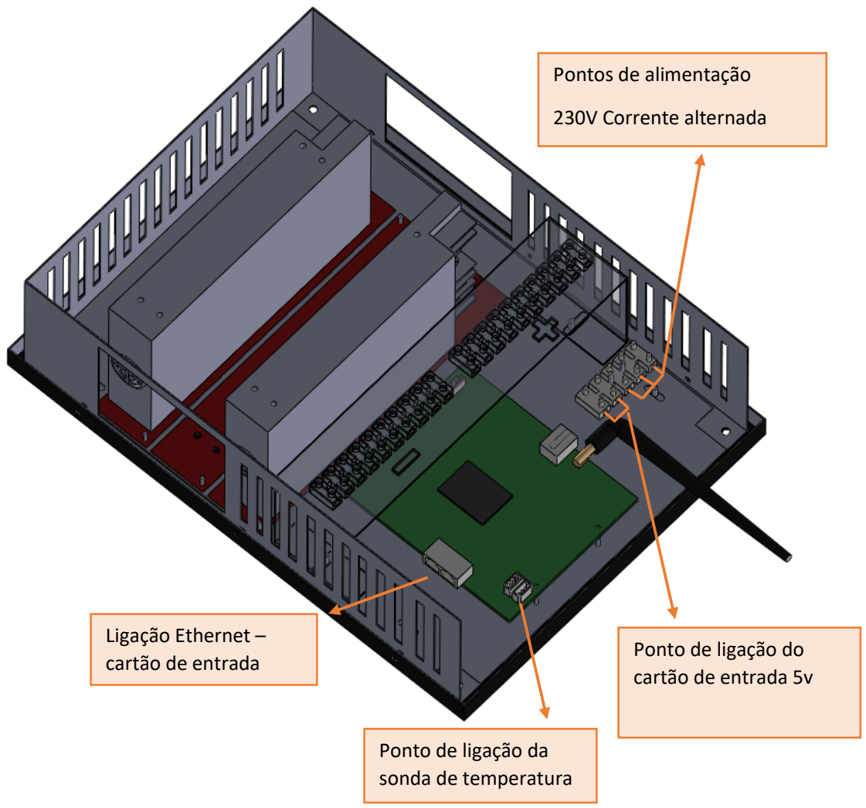
[picture p74: figure]
Pontos de alimentação; 230V Corrente alternada; Ponto de ligação do cartão de entrada 5v; Ponto de ligação da sonda de temperatura; Ligação Ethernet – cartão de entrada

Nesta versão a CPU inclui o router (conforme imagen) e é alterada a posição do ponto de ligação do cartão de dados (RECEIVING CARD).

A interacção com esta CPU mantém-se relativamente à versão anterior com excepção do nome da rede Wifi que passa a ter o nome da cruz (AVEIRO P10, AVEIRO P6.67) e tem palavra-passe Affinity.

Nesta versão a Caixa da cruz Aveiro P10 não é compatível com a Caixa da cruz Aveiro P6,67 em termos de software e requer reconfiguração (ao contrario da versão anterior)

Esta versão inclui sonda de temperatura ligada no ponto indicado na imagen anterior. A sonda de temperatura incluí uma ferramenta em ViPlex Express denominada DETECÇÂO do AMBIENTE para visualizar os valores térmicos na cruz. Seleccionando esta ferramenta surge um menú lateral onde dever ser escolhida aunicamenete a temperatura (mais nformação no manual do utilizador ponto 1.5 alinea 9).

8.2. ATUALIZAÇÃO DO RECEIVING CARD P6.67

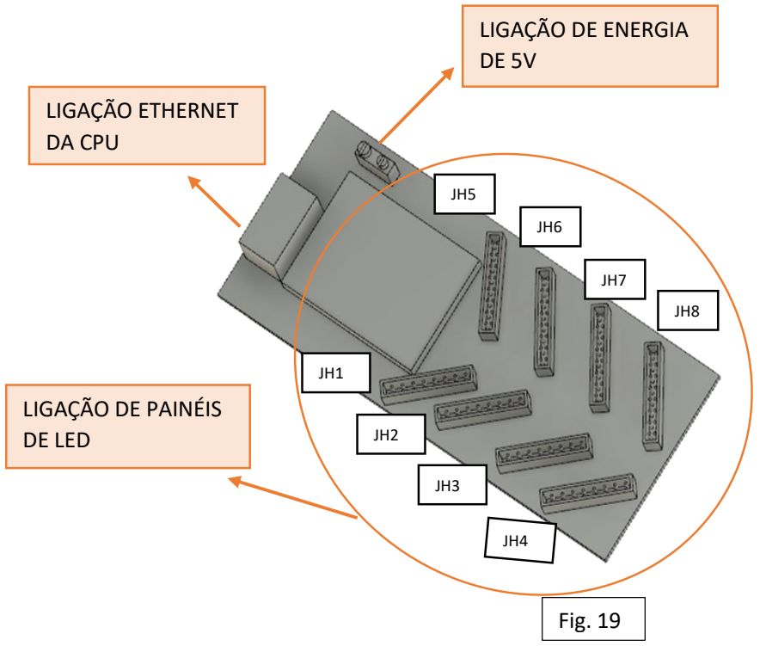
[picture p75: figure]
Fig. 19; LIGAÇÃO DE ENERGIA DE 5V; LIGAÇÃO ETHERNET DA CPU; LIGAÇÃO DE PAINÉIS DE LED

Como você pode ver, a numeração das portas de dados é a mesma do cartão receptor anterior.

Por outro lado, é importante ter em mente que o esquema de conexão do barramento de dados é o mesmo da versão anterior.
