ChristianAffinity/Cruz-AVEIRO/P10/Single Side P10/Files Setup single side P10 32X32 2SZT MRV336+T3/LD2004005 P10.PNG

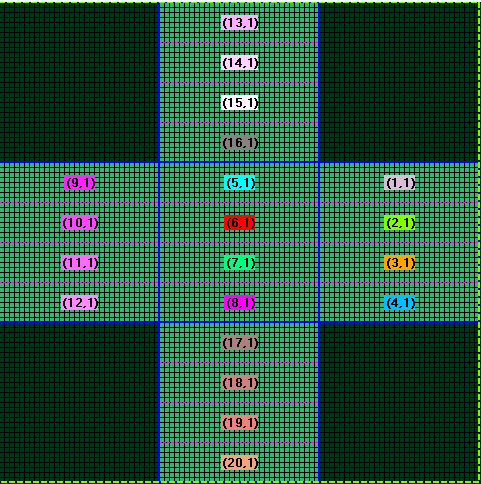
P10/Single Side P10/Files Setup single side P10 32X32 2SZT MRV336+T3/LD2004005 P10.PNG
