ChristianAffinity/Cruz-AVEIRO/CAD/CAD CHASIS/Ensamblaje Cruz Aveiro Dibujo v1.pdf

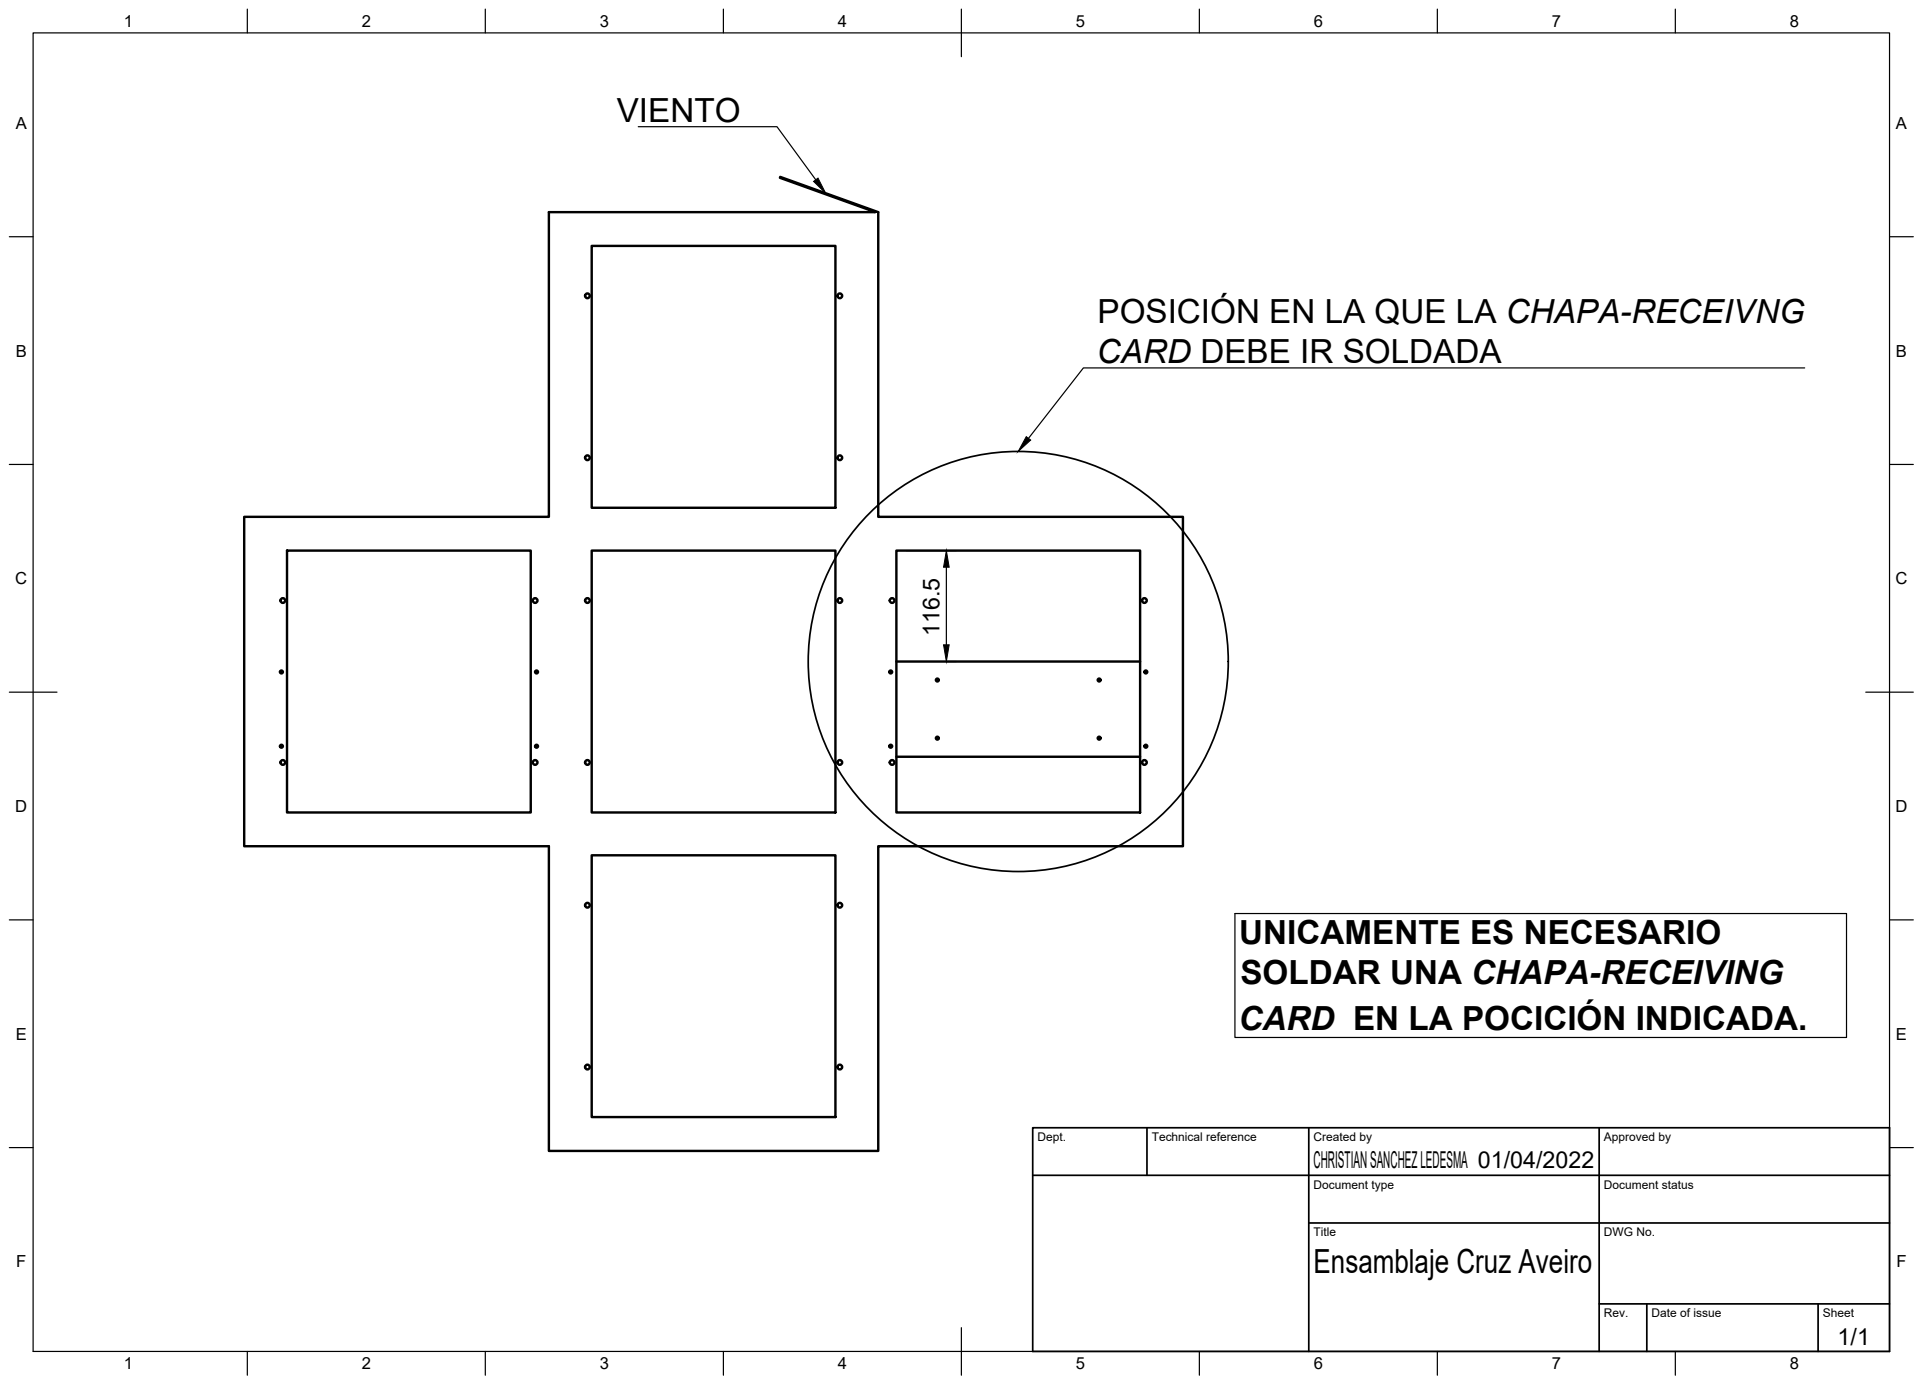
[picture p78: page 1]
Title; DWG No.; Rev.; Date of issue; Sheet

POSICIÓN EN LA QUE LA CHAPA-RECEIVNG

CARD DEBE IR SOLDADA 116.5

UNICAMENTE ES NECESARIO
SOLDAR UNA CHAPA-RECEIVING
CARD EN LA POCICIÓN INDICADA.

Dept. | Technical reference | Created by CHRISTIAN SANCHEZ LEDESMA 01/04/2022 | Approved by

Document type | Document status

Ensamblaje Cruz Aveiro
