ChristianAffinity/Cruz-AVEIRO/P10/cable plano P10 16P 40cm.pdf

800 MM

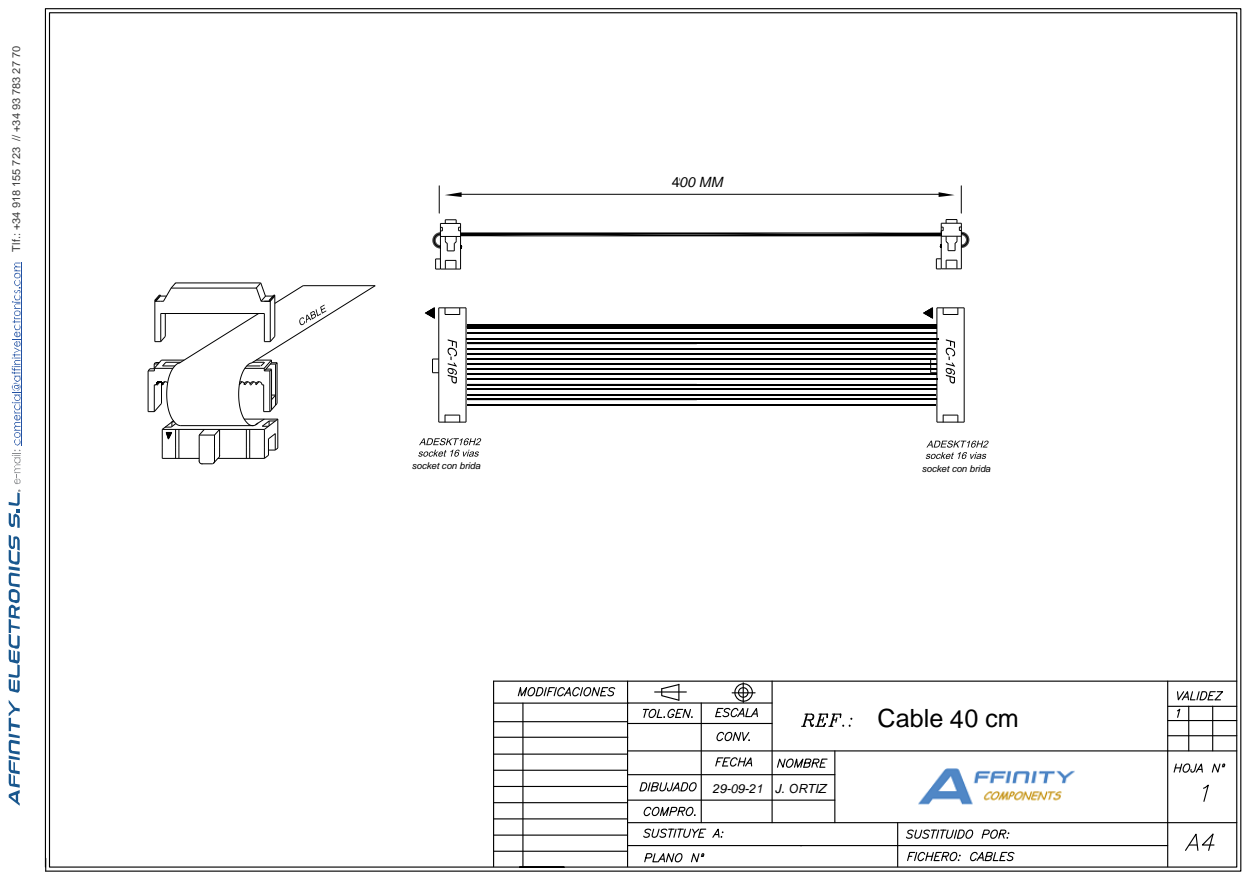
[picture p79: page 1]
socket con brida; Cable 80 cm; J. ORTIZ; Tlf.: +34 918 155 723 // +34 93 783 27 70
