ChristianAffinity/Cruz-AVEIRO/P10/cable plano P10 16P 90cm.pdf

600 MM

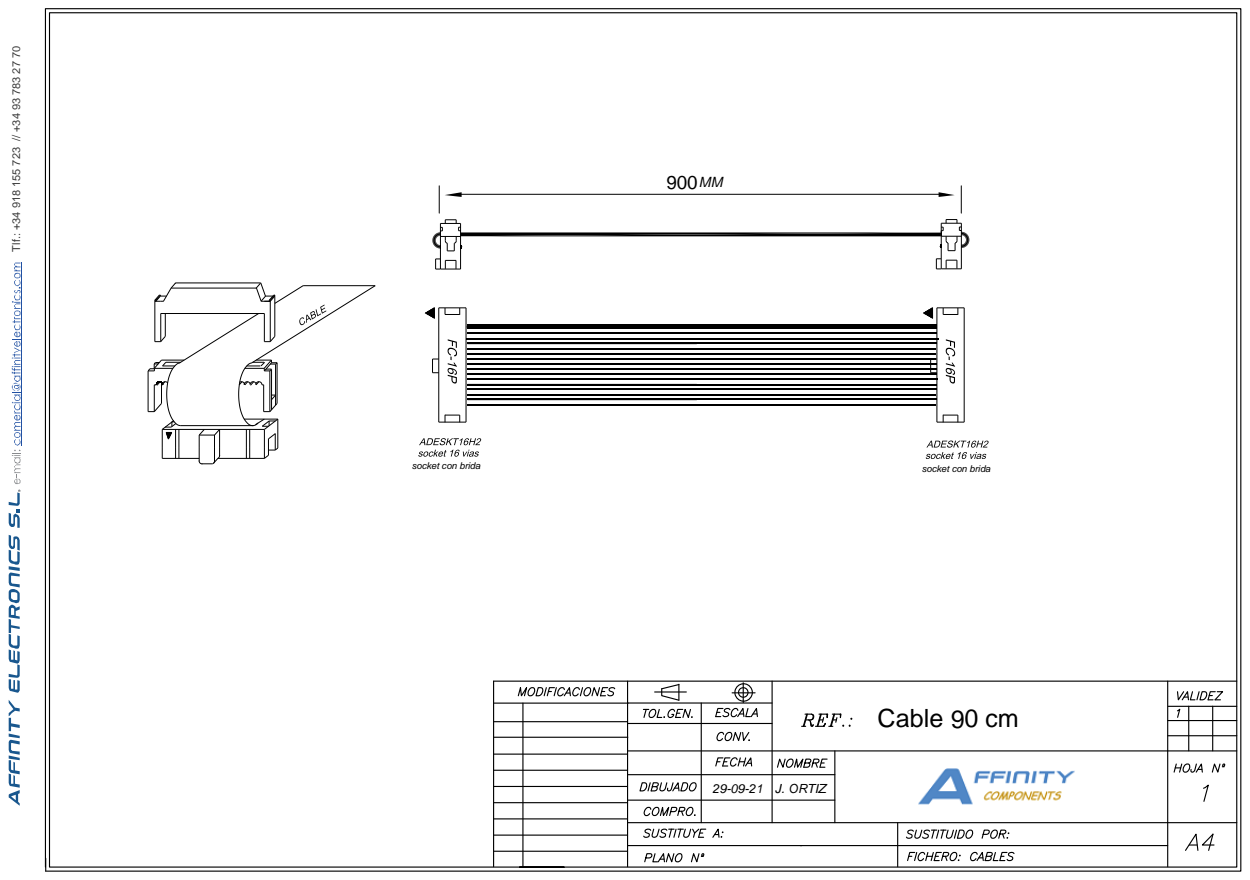
[picture p80: page 1]
socket con brida; Cable 60 cm; J. ORTIZ; Tlf.: +34 918 155 723 // +34 93 783 27 70
