ChristianAffinity/Cruz-AVEIRO/P10/EscandalloCable Aveiro P10.pdf

# hembra Tipo JST paso 3.96

# Conector 4 vias

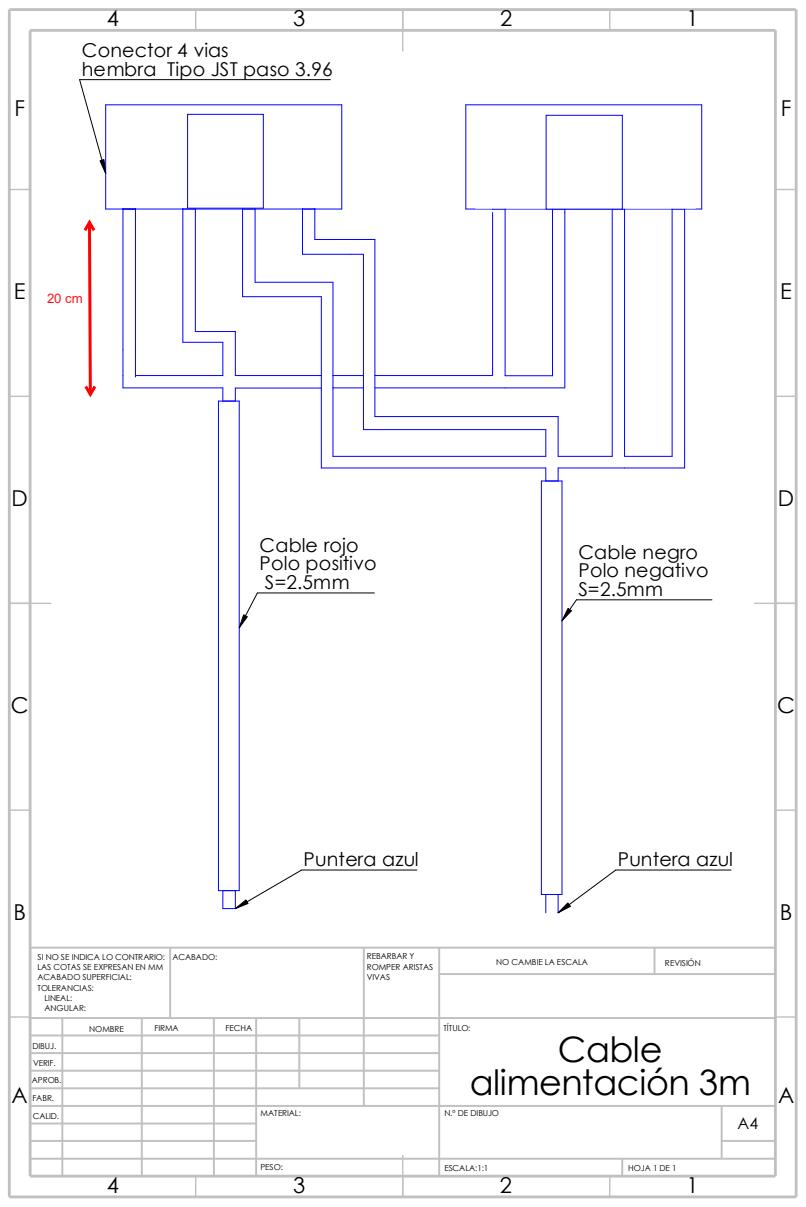
[picture p81: page 1]
Polo positivo; Cable rojo; Cable negro; Polo negativo S=2.5mm; Puntera azul; VIVAS; REVISIÓN; HOJA 1 DE 1; LAS COTAS SE EXPRESAN EN MM; ROMPER ARISTAS; ACABADO:; REBARBAR Y; NO CAMBIE LA ESCALA; PESO:; ESCALA:1:1

SI NO SE INDICA LO CONTRARIO:
ACABADO SUPERFICIAL:
TOLERANCIAS:
LINEAL:
ANGULAR:

NOMBRE | FIRMA | FECHA | | | | TÍTULO: Cable alimentación 3m

DIBUJ.
VERIF.
APROB.
FABR.
CALID. | | | | MATERIAL: | N.º DE DIBUJO | A4
