ChristianAffinity/Cruz-AVEIRO/CAD/CAD CHASIS/Chapa Receiving Card Dibujo v4.pdf

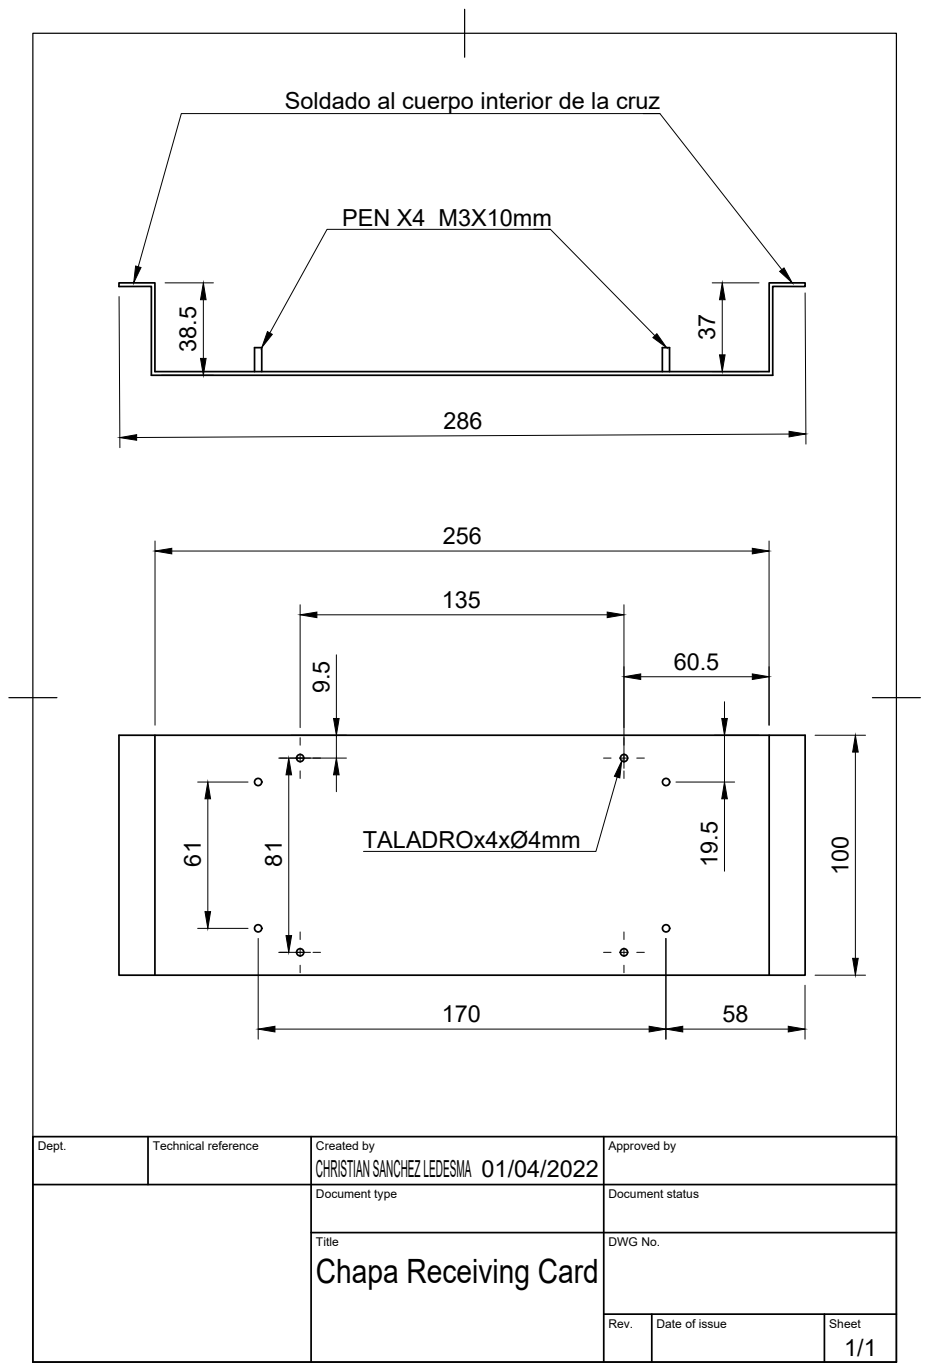
[picture p82: page 1]
PEN X4 M3X10mm

Soldado al cuerpo interior de la cruz

CHRISTIAN SANCHEZ LEDESMA 61

Dept. | Technical reference | Created by 01/04/2022 | Approved by

Document type | Document status

Title Chapa Receiving Card | DWG No.

Rev. | Date of issue | Sheet 1/1
