ChristianAffinity/Cruz-AVEIRO/CAD/CAD Fuente alimentación/2D/Plano base tapa fuente aveiro.pdf

E E

F F

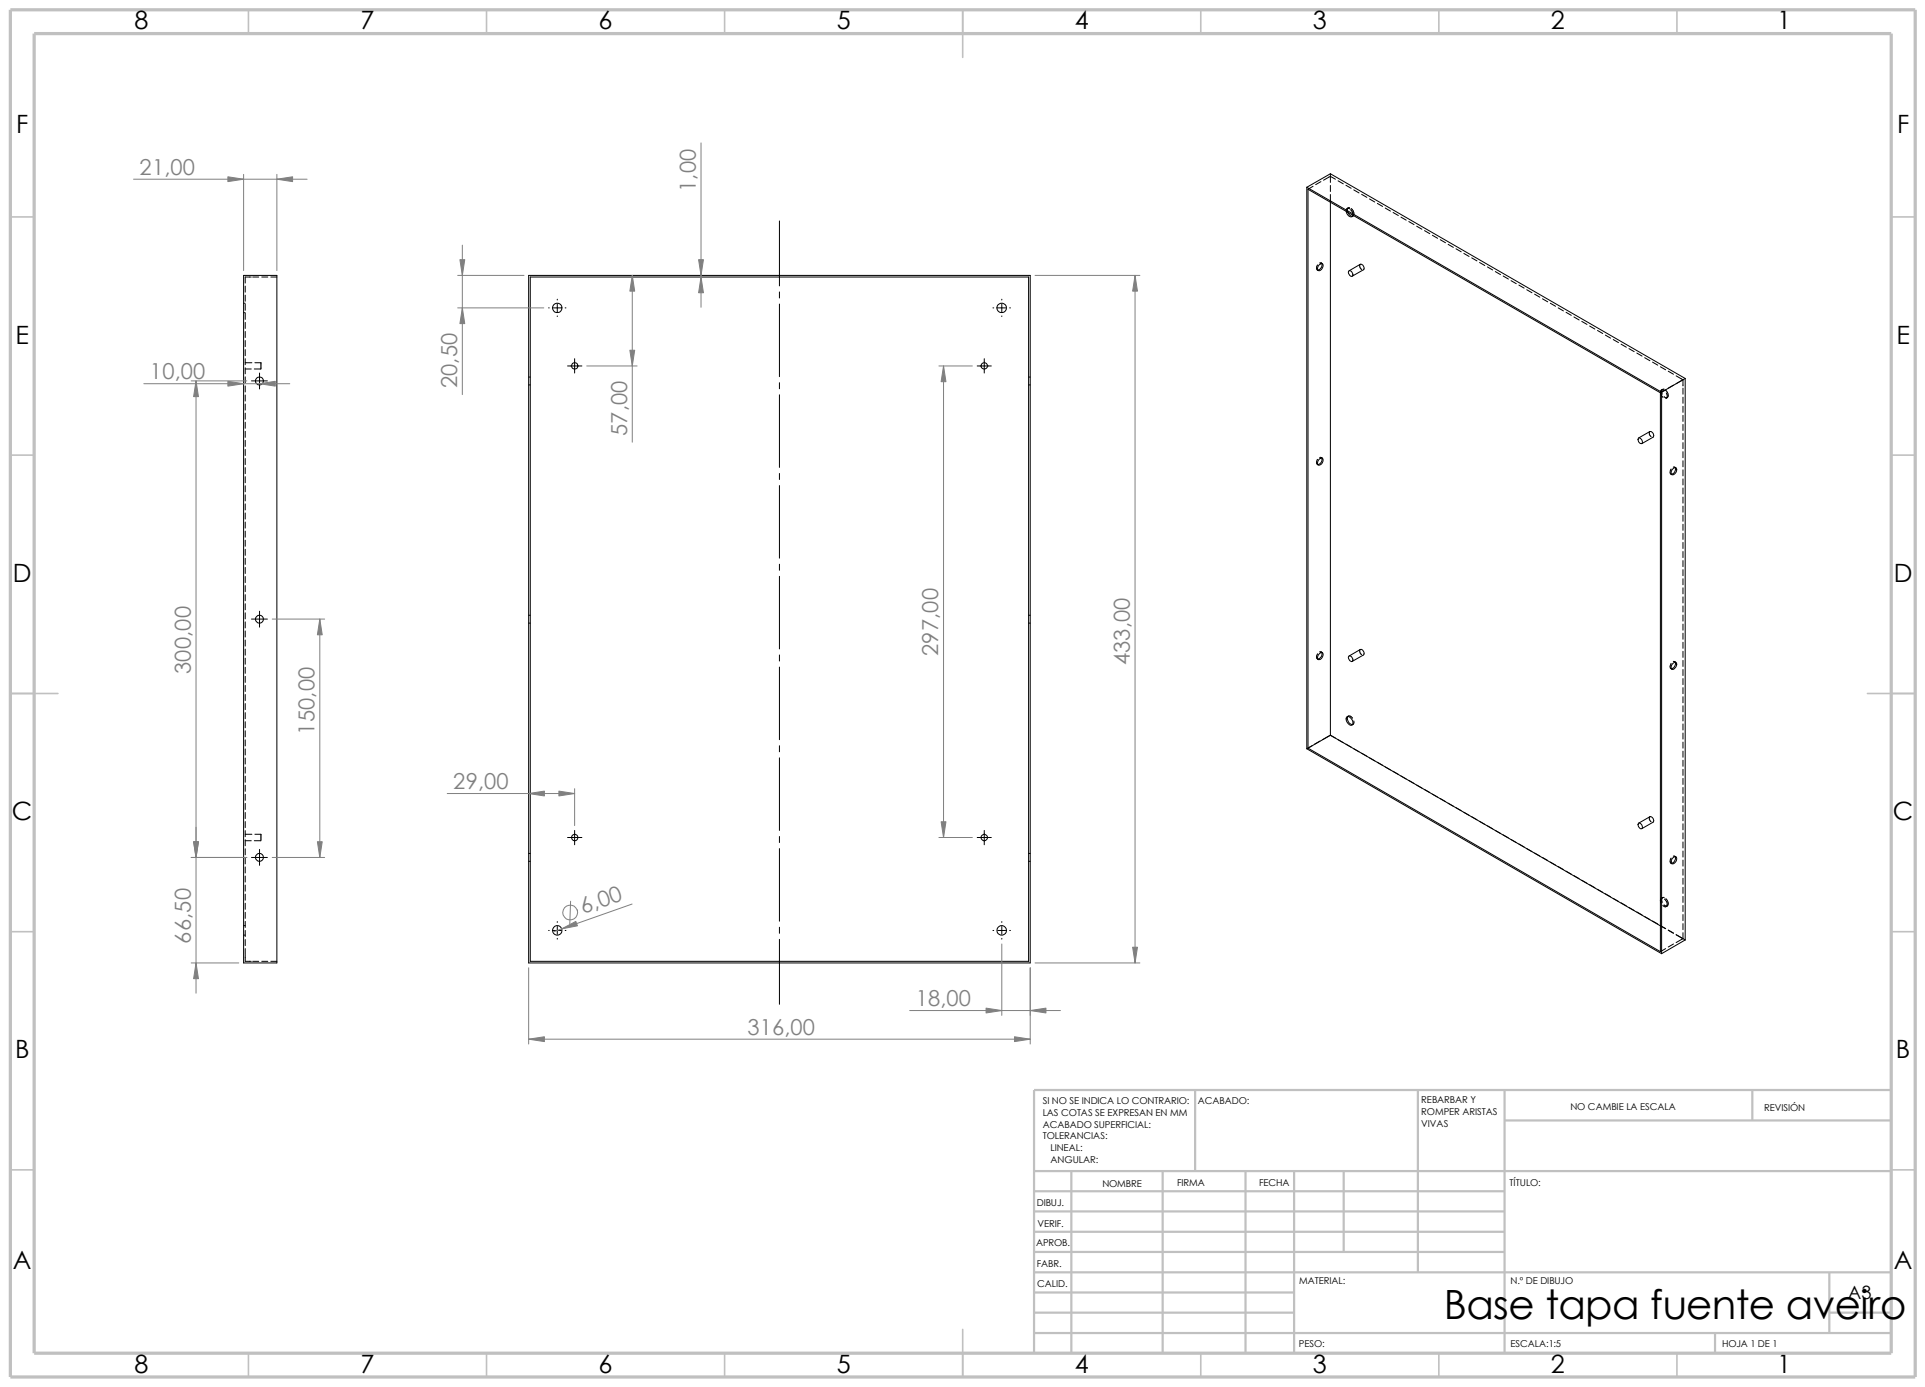
[picture p83: page 1]
PESO:; HOJA 1 DE 1; ESCALA:1:5; NO CAMBIE LA ESCALA; REVISIÓN SI NO SE INDICA LO CONTRARIO:; Base tapa fuente aveiro ⁵⁷,00

LAS COTAS SE EXPRESAN EN MM ACABADO SUPERFICIAL: TOLERANCIAS: LINEAL: ANGULAR: | ACABADO: | REBARBAR Y ROMPER ARISTAS VIVAS

NOMBRE | FIRMA | FECHA | | | | TÍTULO:

DIBUJ.
VERIF.
APROB.

FABR.
CALID. | | | | MATERIAL: | N.º DE DIBUJO | A3
