ChristianAffinity/Cruz-AVEIRO/CAD/CAD Fuente alimentación/2D/Plano cable alimentacion 3m.pdf

# Conector 4 vias hembra Tipo JST paso 3.96

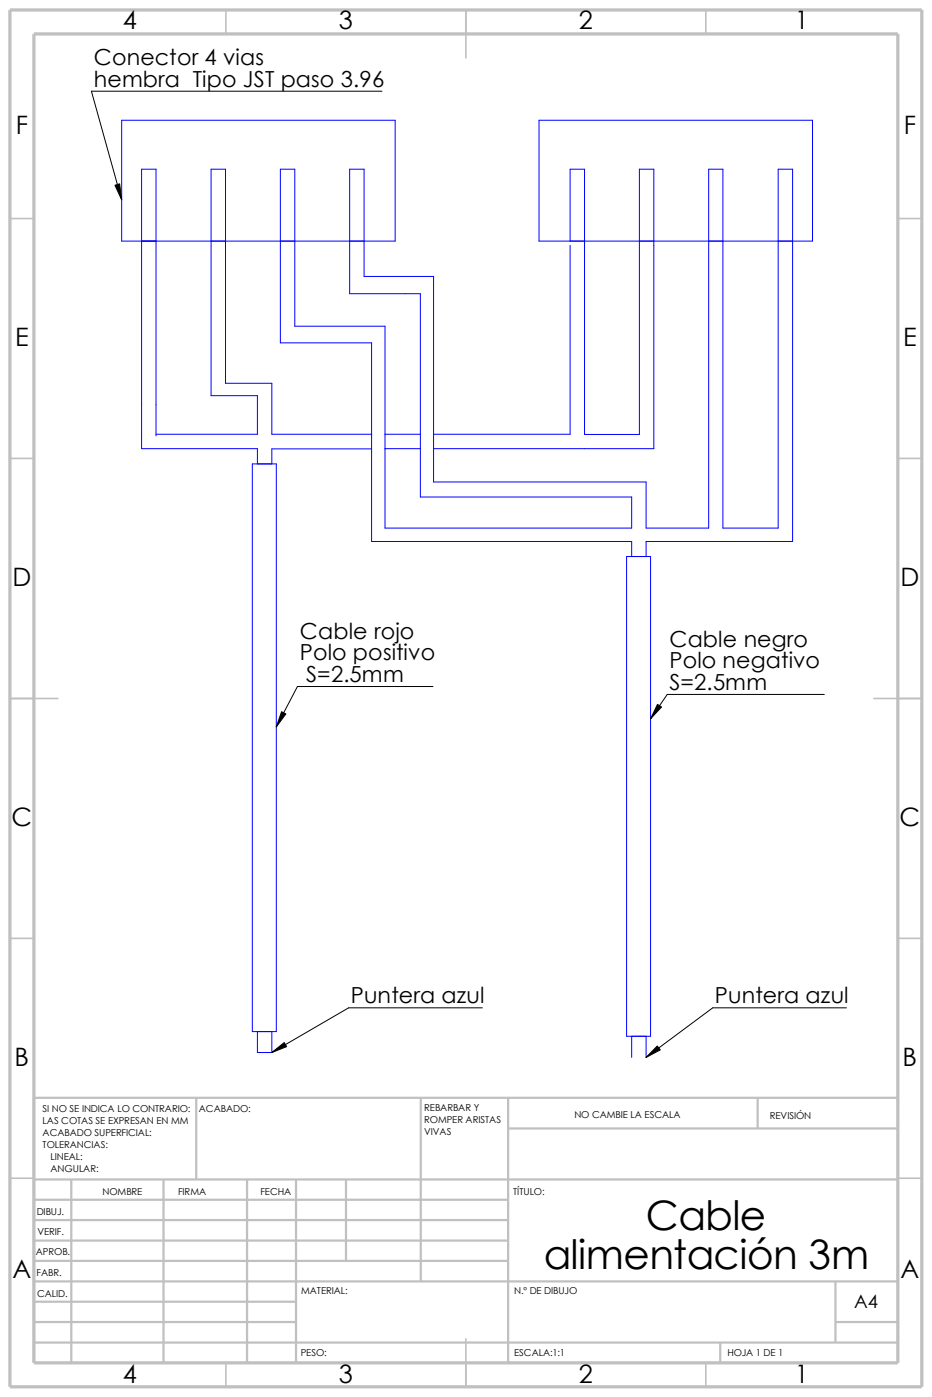
[picture p84: page 1]
Polo positivo; Cable rojo; Cable negro Polo negativo S=2.5mm; Puntera azul; MATERIAL:; ROMPER ARISTAS; FABR.; ESCALA:1:1; REVISIÓN; VIVAS; N.º DE DIBUJO; HOJA 1 DE 1; PESO:; REBARBAR Y; CALID.; ACABADO:

SI NO SE INDICA LO CONTRARIO:
LAS COTAS SE EXPRESAN EN MM
ACABADO SUPERFICIAL:
TOLERANCIAS:
LINEAL:
ANGULAR:

NO CAMBIE LA ESCALA

NOMBRE | FIRMA | FECHA | TÍTULO: Cable alimentación 3m

DIBUJ.
VERIF.
APROB.
