ChristianAffinity/Cruz-AVEIRO/CAD/CAD Fuente alimentación/2D/Plano Chapa fuente aveiro V3.0.pdf

E E

F F

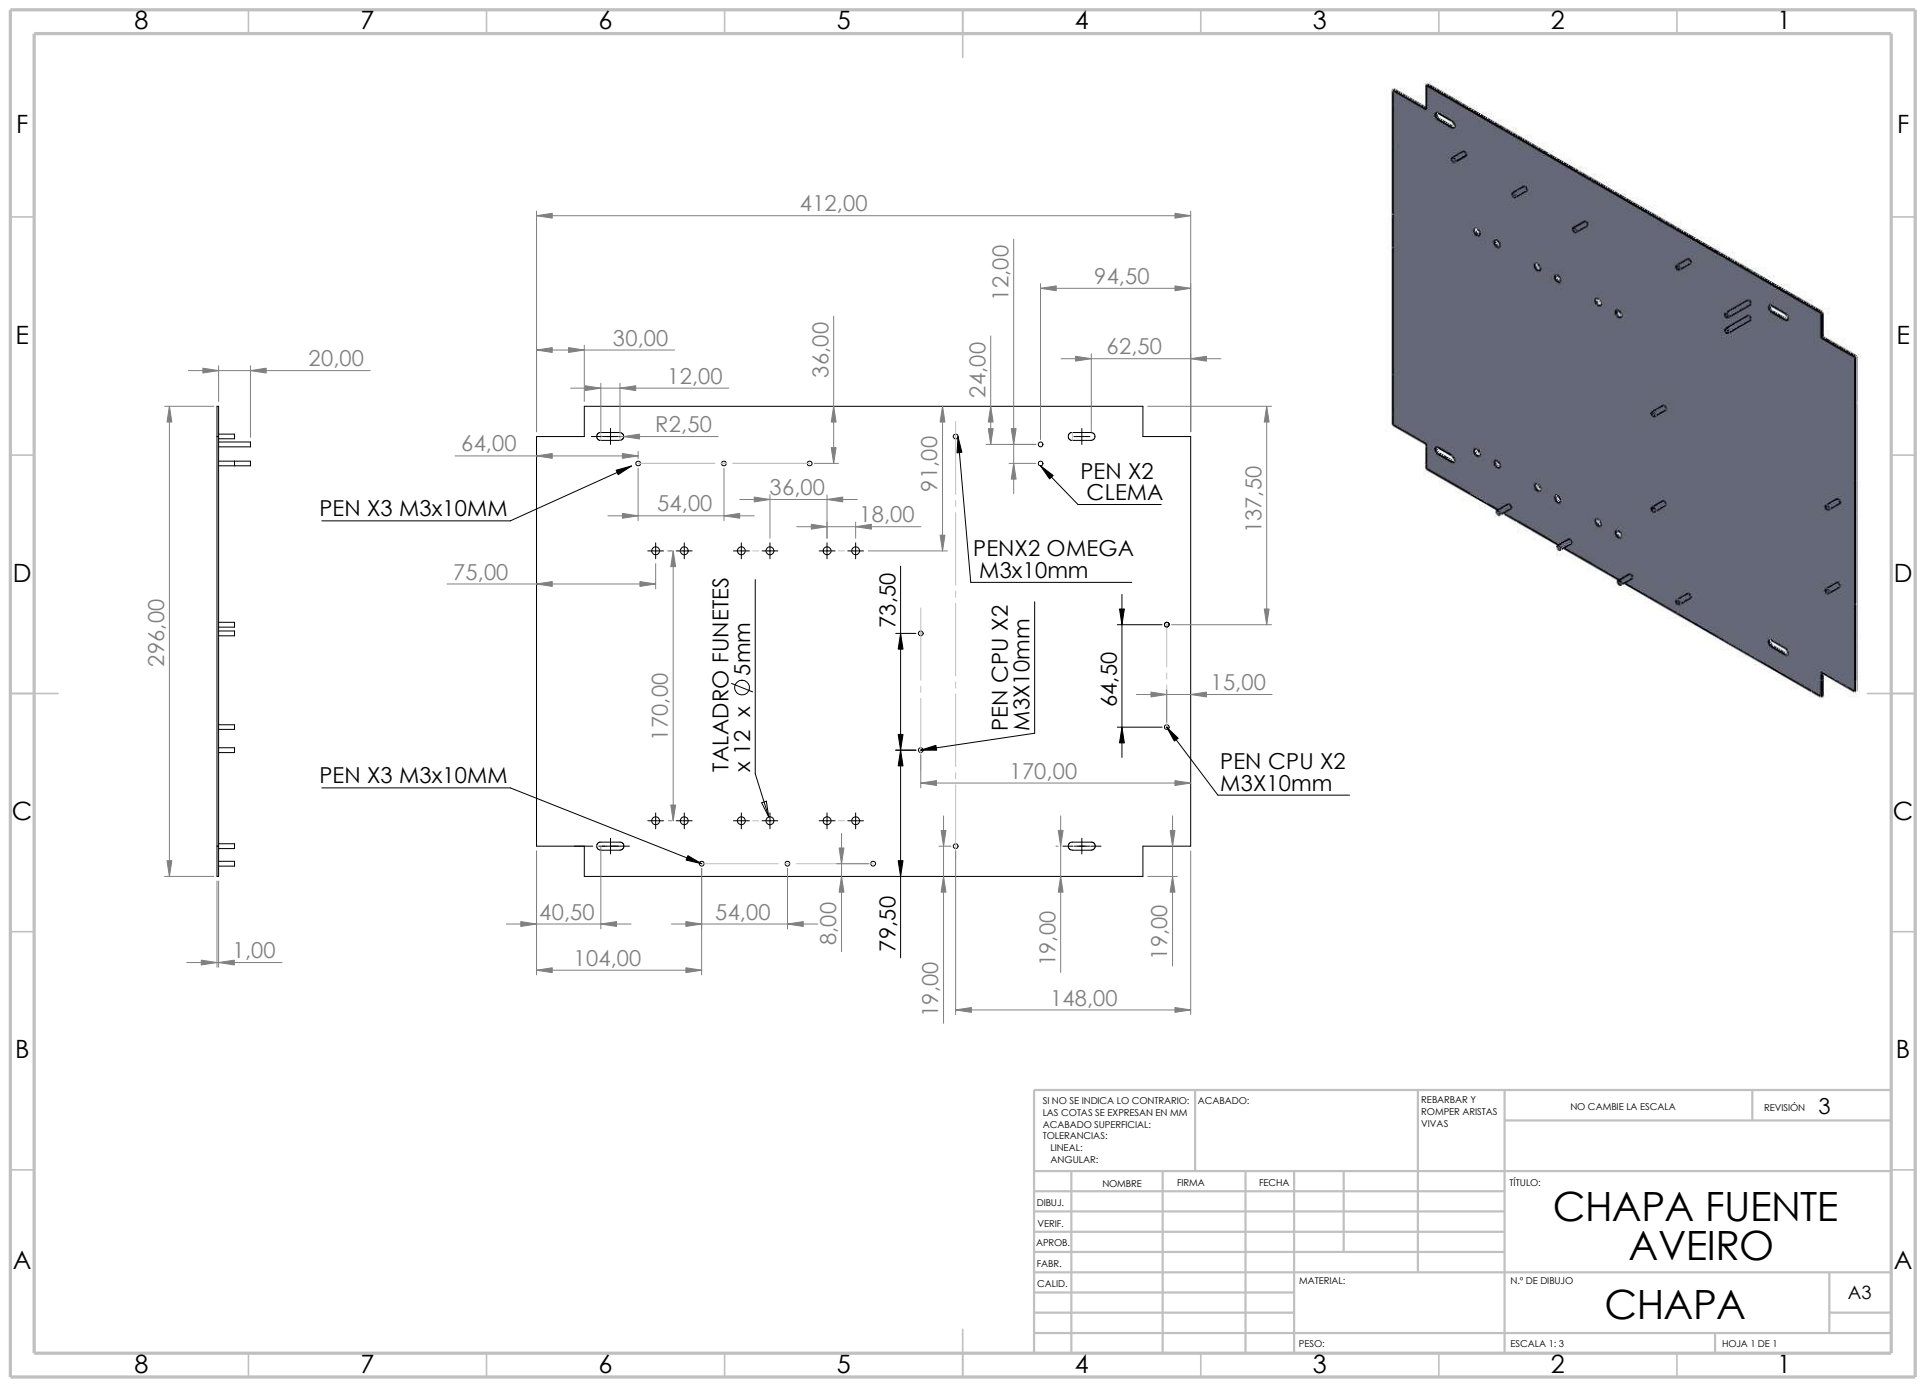
[picture p85: page 1]
ROMPER ARISTAS; ESCALA 1: 3; HOJA 1 DE 1; PESO:; ACABADO:; VIVAS; NO CAMBIE LA ESCALA; REVISIÓN SI NO SE INDICA LO CONTRARIO:; REBARBAR Y; PEN X3 M3x10MM; PENX2 OMEGA; PEN X2; CLEMA TALADRO FUNETES x 12 x; PEN CPU X2 ⁵mm; PEN CPU X2 M³X10mm ¹²,00 19,00

LAS COTAS SE EXPRESAN EN MM
ACABADO SUPERFICIAL:
TOLERANCIAS:
LINEAL:
ANGULAR:

NOMBRE | FIRMA | FECHA | | | | TÍTULO: CHAPA FUENTE AVEIRO

DIBUJ.
VERIF.
APROB.
CALID. | | | | MATERIAL: | N.º DE DIBUJO CHAPA | A3

FABR.
