ChristianAffinity/Cruz-AVEIRO/CAD/CAD Fuente alimentación/2D/Plano proteccion fuente aveiro.pdf

E E

F F

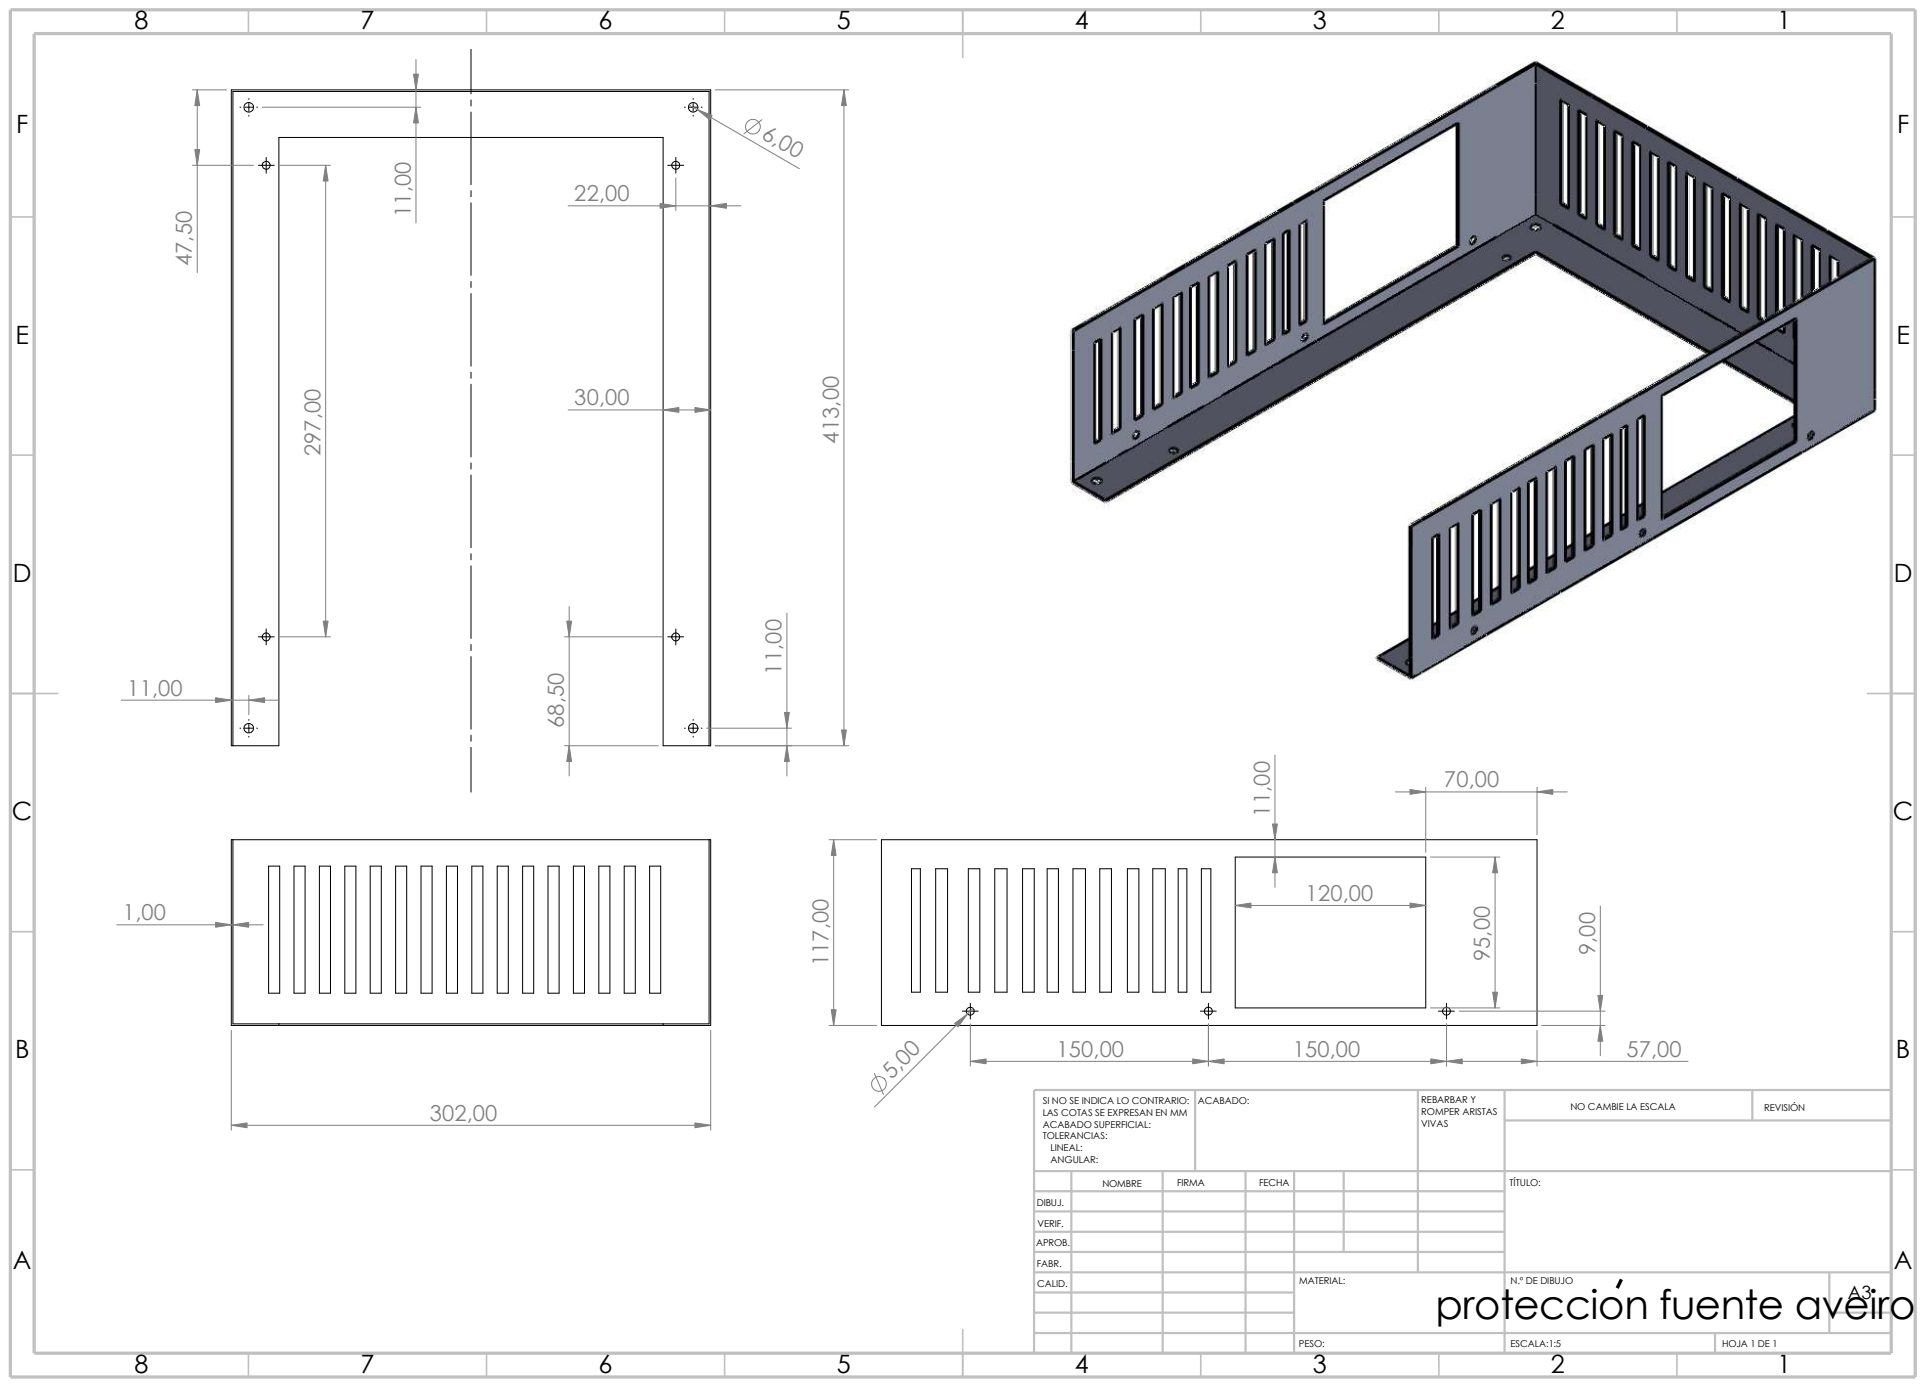
[picture p86: page 1]
PESO:; ESCALA:1:5; HOJA 1 DE 1; NO CAMBIE LA ESCALA; REVISIÓN SI NO SE INDICA LO CONTRARIO:; proteccion fuente aveiro ⁴⁷,50; 150,00 ¹¹⁷,00

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

NOMBRE | FIRMA | FECHA | | | | TÍTULO:

DIBUJ.
VERIF.
APROB.
CALID. | | | | MATERIAL: | N.º DE DIBUJO | A3

FABR.
