ChristianAffinity/Cruz-AVEIRO/(commit log)

2021-09-20 Primer Commit
    [Base tapa fuente aveiro.SLDDRW, Base tapa fuente aveiro.SLDPRT, CHAPA.SLDDRW, CHAPA.SLDPRT, Ensamblaje1.SLDASM, Escandallo Aveiro P10.xlsx, Plano cable 3m alimentacion paneles AVEIRO.SLDDRW, fuente RSP-500-5.SLDPRT]
2021-09-20 SE añade el escandallo de la cruz completo
2021-09-23 Añadido carpeta P6 y P10 doble side
    [Escandallo Aveiro P10.xlsx]
2021-09-23 Commit Aux
    [Escandallo Aveiro P10.xlsx]
2021-09-28 Actualización escandallos P10 y P6.67
    [Escandallo Aveiro P10.xlsx]
2021-09-29 Se añade planos cables y excel con escandallo P10 y P6.67
    [Escandallo Aveiro P10 DOUBLE SIDE.xlsx, Escandallo Aveiro P10 single side.xlsx, Escandallo Aveiro P6.67 y P10.xlsx, Escandallo Aveiro P6.76.xlsx, Spare Parts List-2004005-P10-1.xlsx]
2021-10-04 Se aña de cad del chasis
    [Base tapa fuente aveiro.SLDDRW, Base tapa fuente aveiro.SLDPRT, CHAPA.SLDDRW, CHAPA.SLDPRT, Ensamblaje1.SLDASM, Plano cable 3m alimentacion paneles AVEIRO.SLDDRW, fuente RSP-500-5.SLDPRT, proteccion fuente aveiro.SLDDRW]
2021-10-14 Se añade las tuercas M3 a la fuente d ela P6.67
    [Escandallo Aveiro P6.76.xlsx]
2021-10-14 Se corrige longitudes de cables paralelos, se estandariza en 90y 40 cm
    [Escandallo Aveiro P10 DOUBLE SIDE.xlsx, Escandallo Aveiro P10 single side.xlsx]
2021-11-04 Se añaden planos cable datos p10 y p6.67
    [Escandallo Aveiro P10 DOUBLE SIDE.xlsx, Escandallo Aveiro P6.76.xlsx]
2021-11-29 se añade manual de montaje
2021-11-30 Se añade el manual
2021-12-03 Se modifica manual montaje aveiro a la v1.1
2022-04-19 Se añade modifcacion receiving card Hub mas grande d ela p6.67
    [CARA 1 Interior AVEIRO v20.step]
